aspyra/Rc_Engine_Sound_ESP32/hardware/SMD_ESC-inside_KiCad/RC_Engine_Sound_ESP32.kicad_pcb

## KiCad design hardware/SMD_ESC-inside_KiCad/RC_Engine_Sound_ESP32.kicad_pcb (2023-11-29)

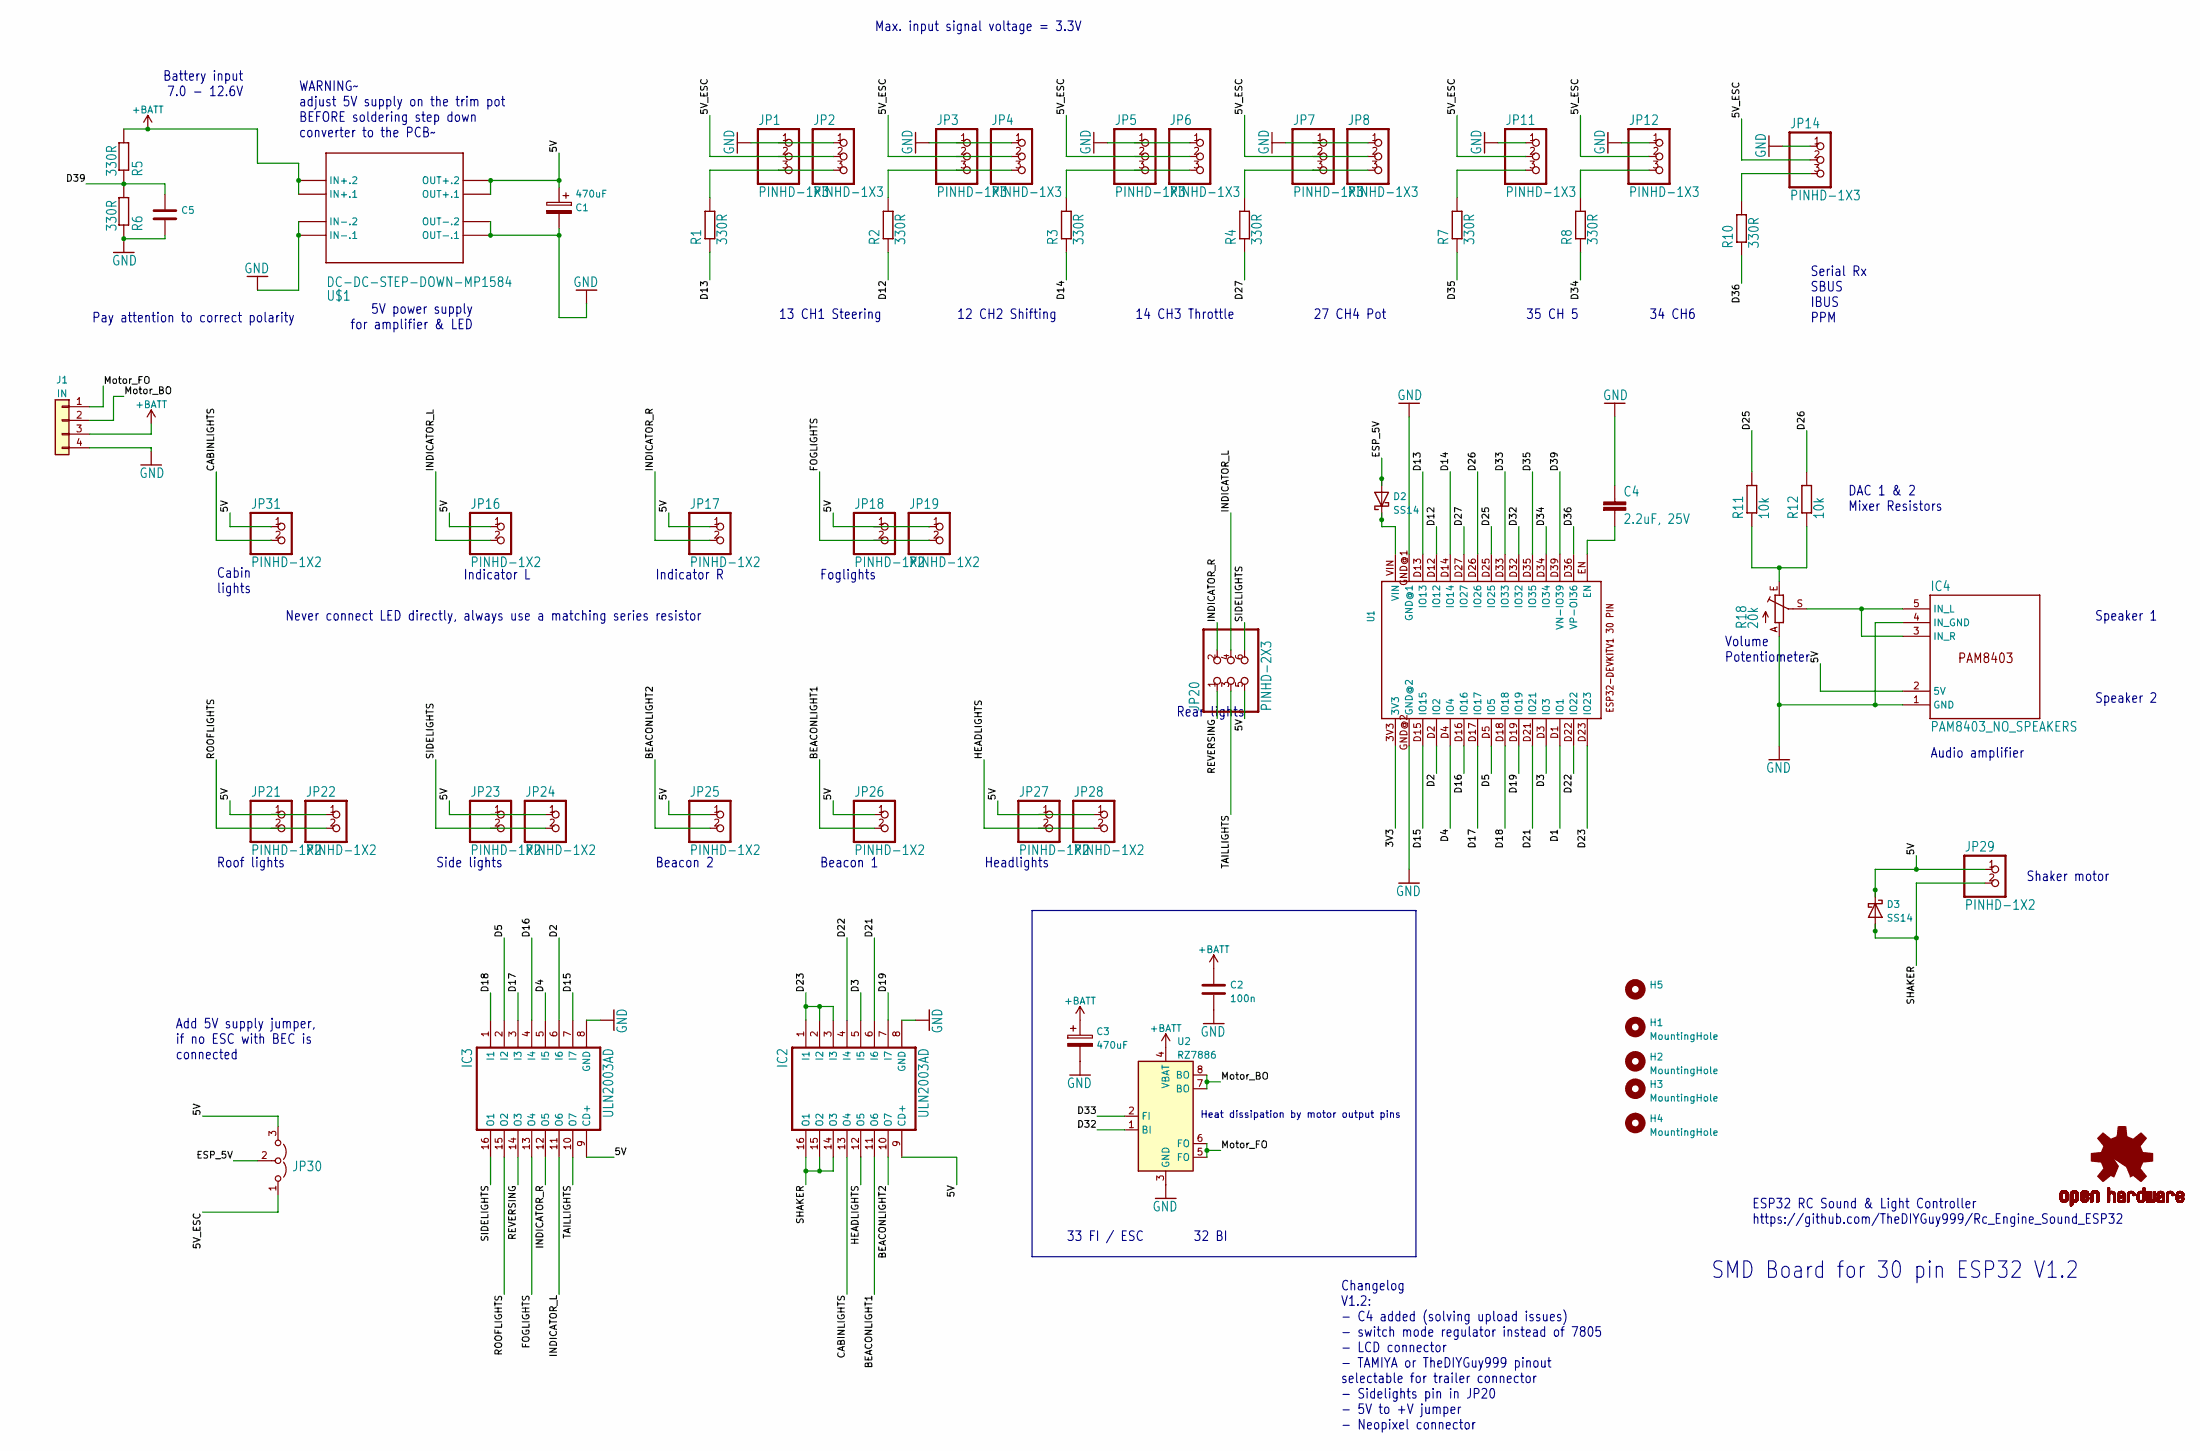
[picture p1: schematic RC_Engine_Sound_ESP32.kicad_sch]

Parts:
C1, C3: 470uF; CP_Radial_D10.0mm_P2.50mm_P5.00mm
C2: 100n; C_0603_1608Metric_Pad1.08x0.95mm_HandSolder
C4: 2.2uF, 25V; C_0805_2012Metric_Pad1.18x1.45mm_HandSolder
C5: C_0603_1608Metric_Pad1.08x0.95mm_HandSolder
D2, D3: SS14; D_SOD-123F
H1, H2, H3, H4: MountingHole; MountingHole_3.2mm_M3_DIN965
H5: (no value)
IC2, IC3: ULN2003AD; SO16
IC4: PAM8403_NO_SPEAKERS; PAM8403_SPEAKERS
J1: IN; TerminalBlock_Phoenix_PT-1,5-4-3.5-H_1x04_P3.50mm_Horizontal
JP1, JP2, JP3, JP4, JP5, JP6, JP7, JP8, JP11, JP12, JP14: PINHD-1X3; 1X03
JP16, JP17, JP18, JP19, JP21, JP22, JP23, JP24, JP25, JP26, JP27, JP28, JP29, JP31: PINHD-1X2; 1X02
JP20: PINHD-2X3; 2X03
JP30: (no value)
LOGO1: OSHW-LOGOM; OSHW-LOGO-M
R1, R2, R3, R4, R5, R6, R7, R8, R10: 330R; R_0603_1608Metric_Pad0.98x0.95mm_HandSolder
R11, R12: 10k; R_0603_1608Metric_Pad0.98x0.95mm_HandSolder
R18: 20k; S64W
U1: ESP32DEVKITV1; ESP32-DEVKITV1
U2: RZ7886; DIP-8_W7.62mm_LongPads
U$1: DC-DC-STEP-DOWN-MP1584

Connections:
+BATT: C2.1, C3.1, J1.3, R5.2, U2.4 (VBAT), U$1.IN+.1, U$1.IN+.2
/3V3: U1.3V3
/5V: C1.1, D3.1 (K), IC2.9 (CD+), IC3.9 (CD+), IC4.2 (5V), JP16.1, JP17.1, JP18.1, JP19.1, JP20.5, JP21.1, JP22.1, JP23.1, JP24.1, JP25.1, JP26.1, JP27.1, JP28.1, JP29.1, JP30.3 (B), JP31.1, U$1.OUT+.1, U$1.OUT+.2
/5V_ESC: JP1.2, JP2.2, JP3.2, JP4.2, JP5.2, JP6.2, JP7.2, JP8.2, JP11.2, JP12.2, JP14.2, JP30.1 (A)
/BEACONLIGHT1: IC2.11 (O6), JP26.2
/BEACONLIGHT2: IC2.10 (O7), JP25.2
/CABINLIGHTS: IC2.13 (O4), JP31.2
/D1: U1.D1 (IO1)
/D2: IC3.6 (I6), U1.D2 (IO2)
/D3: IC2.5 (I5), U1.D3 (IO3)
/D4: IC3.5 (I5), U1.D4 (IO4)
/D5: IC3.2 (I2), U1.D5 (IO5)
/D12: R2.1, U1.D12 (IO12)
/D13: R1.1, U1.D13 (IO13)
/D14: R3.1, U1.D14 (IO14)
/D15: IC3.7 (I7), U1.D15 (IO15)
/D16: IC3.4 (I4), U1.D16 (IO16)
/D17: IC3.3 (I3), U1.D17 (IO17)
/D18: IC3.1 (I1), U1.D18 (IO18)
/D19: IC2.7 (I7), U1.D19 (IO19)
/D21: IC2.6 (I6), U1.D21 (IO21)
/D22: IC2.4 (I4), U1.D22 (IO22)
/D23: IC2.1 (I1), IC2.2 (I2), IC2.3 (I3), U1.D23 (IO23)
/D25: R11.2, U1.D25 (IO25)
/D26: R12.2, U1.D26 (IO26)
/D27: R4.1, U1.D27 (IO27)
/D32: U1.D32 (IO32), U2.1 (BI)
/D33: U1.D33 (IO33), U2.2 (FI)
/D34: R8.1, U1.D34 (IO34)
/D35: R7.1, U1.D35 (IO35)
/D36: R10.1, U1.D36 (VP-OI36)
/D39: C5.1, R5.1, R6.2, U1.D39 (VN-IO39)
/ESP_5V: D2.2 (A), JP30.2 (C)
/FOGLIGHTS: IC3.13 (O4), JP18.2, JP19.2
/HEADLIGHTS: IC2.12 (O5), JP27.2, JP28.2
/INDICATOR_L: IC3.11 (O6), JP16.2, JP20.4
/INDICATOR_R: IC3.12 (O5), JP17.2, JP20.2
/Motor_BO: J1.2, U2.7 (BO), U2.8 (BO)
/Motor_FO: J1.1, U2.5 (FO), U2.6 (FO)
/REVERSING: IC3.14 (O3), JP20.1
/ROOFLIGHTS: IC3.15 (O2), JP21.2, JP22.2
/SHAKER: D3.2 (A), IC2.14 (O3), IC2.15 (O2), IC2.16 (O1), JP29.2
/SIDELIGHTS: IC3.16 (O1), JP20.6, JP23.2, JP24.2
/TAILLIGHTS: IC3.10 (O7), JP20.3
GND: C1.2, C2.2, C3.2, C4.1, C5.2, IC2.8 (GND), IC3.8 (GND), IC4.1 (GND), IC4.4 (IN_GND), J1.4, JP1.1, JP2.1, JP3.1, JP4.1, JP5.1, JP6.1, JP7.1, JP8.1, JP11.1, JP12.1, JP14.1, R6.1, R18.A, U1.GND@1, U1.GND@2, U2.3 (GND), U$1.IN-.1, U$1.IN-.2, U$1.OUT-.1, U$1.OUT-.2
unnamed: C4.2, U1.EN
unnamed: D2.1 (K), U1.VIN
unnamed: IC4.3 (IN_R), IC4.5 (IN_L), R18.S
unnamed: JP1.3, JP2.3, R1.2
unnamed: JP3.3, JP4.3, R2.2
unnamed: JP5.3, JP6.3, R3.2
unnamed: JP7.3, JP8.3, R4.2
unnamed: JP11.3, R7.2
unnamed: JP12.3, R8.2
unnamed: JP14.3, R10.2
unnamed: R11.1, R12.1, R18.E

Notes on the sheet:
Add 5V supply jumper, if no ESC with BEC is connected~{}
Indicator R
Volume Potentiometer
Shaker motor
35 CH 5
Rear lights
Cabin lights
Side lights
Heat dissipation by motor output pins
Max. input signal voltage = 3.3V~{}
Audio amplifier
Pay attention to correct polarity~{}
Foglights
32 BI
13 CH1 Steering
Speaker 2
Beacon 1
Serial Rx SBUS IBUS PPM
Never connect LED directly, always use a matching series resistor~{}
SMD Board for 30 pin ESP32 V1.2
DAC 1 & 2 Mixer Resistors
14 CH3 Throttle
Headlights
5V power supply for amplifier & LED
ESP32 RC Sound & Light Controller https://github.com/TheDIYGuy999/Rc_Engine_Sound_ESP32
Battery input 7.0 - 12.6V
27 CH4 Pot
34 CH6
Beacon 2
Roof lights
33 FI / ESC
WARNING~ adjust 5V supply on the trim pot BEFORE soldering step down converter to the PCB~
12 CH2 Shifting
Changelog V1.2: - C4 added (solving upload issues) - switch mode regulator instead of 7805 - LCD connector - TAMIYA or TheDIYGuy999 pinout selectable for trailer connector - Sidelights pin in JP20 - 5V to +V jumper - Neopixel connector
Indicator L
Speaker 1

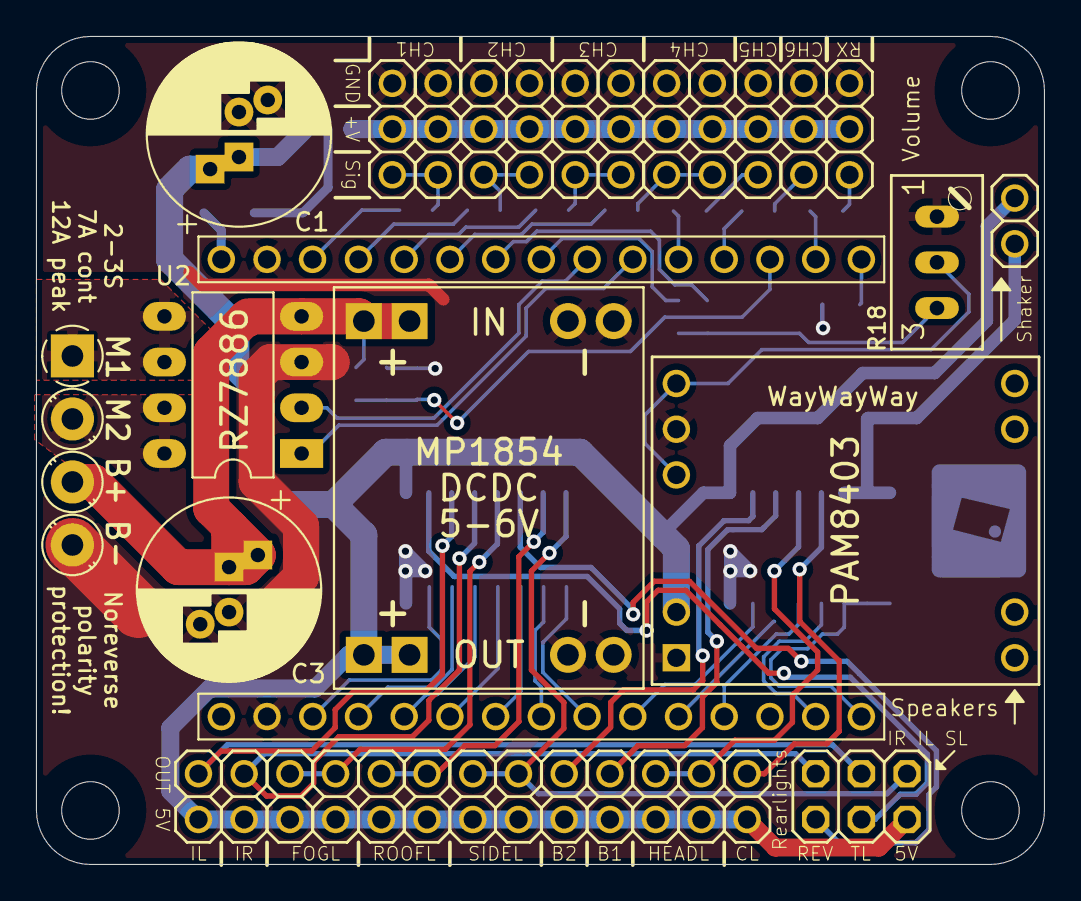
[picture p2: board RC_Engine_Sound_ESP32.kicad_pcb from above]

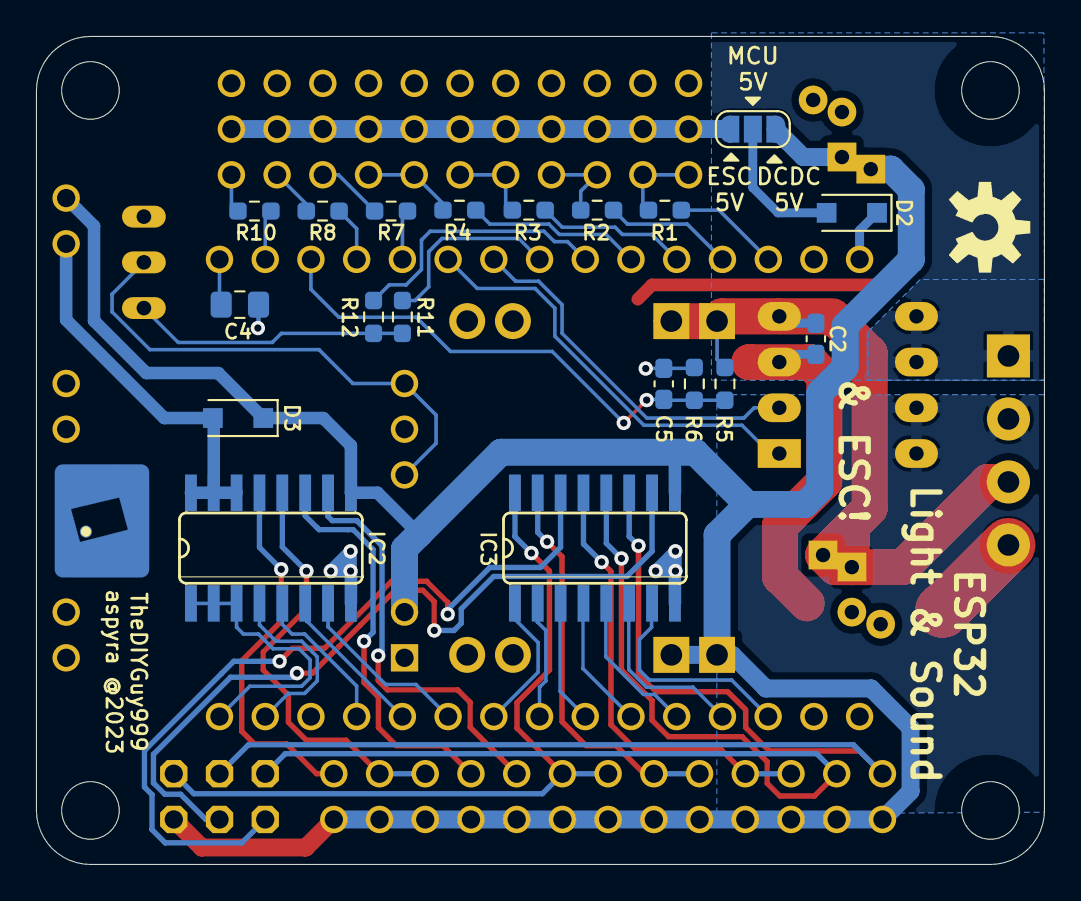
[picture p3: board RC_Engine_Sound_ESP32.kicad_pcb from below]

Board: 2 copper layers, 56.0 x 46.0 mm, 59 parts (21 on the bottom side), 54 nets.
