aspyra/Rc_Engine_Sound_ESP32/src/src.ino

/* RC engine sound & light controller for Arduino ESP32. Written by TheDIYGuy999
    Based on the code for ATmega 328: https://github.com/TheDIYGuy999/Rc_Engine_Sound

    ***** ESP32 CPU frequency must be set to 240MHz! *****

   Sound files converted with: https://github.com/TheDIYGuy999/Rc_Engine_Sound_ESP32/blob/master/tools/Audio2Header.html
   Original converter code by bitluni (send him a high five, if you like the code)

   Parts of automatic transmision code from Wombii's fork: https://github.com/Wombii/Rc_Engine_Sound_ESP32

   Dashboard, Neopixel and SUMD support by Gamadril: https://github.com/Gamadril/Rc_Engine_Sound_ESP32

   Contributors:
   - Christian Fiebig https://github.com/fiechr

   Visual Studio Code IDE support added (you need to install PlatformIO plugin and git https://git-scm.com)
   Arduino IDE is supported as well, but I recommend to use VS Code, because libraries and boards are managed automatically.
*/

char codeVersion[] = "9.12.0"; // Software revision.

//
// =======================================================================================================
// ERROR CODES (INDICATOR LIGHTS, BEEPS)
// =======================================================================================================
//
/*
   Indicators:
   - Constantly on = no SBUS signal (check "sbusInverted" true / false in "2_Remote.h")
   - Number of blinks = this channel signal is not between 1400 and 1600 microseconds and can't be auto calibrated (check channel trim settings)
   - 2 fast blinks = battery error during powering up (see below)
   - 3 fast blinks = no valid receiver bus signal detected / wrong remote configuration

   Beeps (only, if "#define BATTERY_PROTECTION" in "3_ESC.h"):
   - Number of beeps = number of detected battery cells in series
   - 10 fast beeps = battery error, disconnect it!
*/

//
// =======================================================================================================
// ! ! I M P O R T A N T ! !   ALL USER SETTINGS ARE DONE IN THE FOLLOWING TABS, WHICH ARE DISPLAYED ABOVE
// (ADJUST THEM BEFORE CODE UPLOAD), DO NOT CHANGE ANYTHING IN THIS TAB EXCEPT THE DEBUG OPTIONS
// =======================================================================================================
//

#include <Arduino.h>

// All the required user settings are done in the following .h files:
#include "0_generalSettings.h" // <<------- general settings
#include "1_Vehicle.h"         // <<------- Select the vehicle you want to simulate
#include "2_Remote.h"          // <<------- Remote control system related adjustments
#include "3_ESC.h"             // <<------- ESC related adjustments
#include "4_Transmission.h"    // <<------- Transmission related adjustments
#include "5_Shaker.h"          // <<------- Shaker related adjustments
#include "6_Lights.h"          // <<------- Lights related adjustments
#include "7_Servos.h"          // <<------- Servo output related adjustments
#include "8_Sound.h"           // <<------- Sound related adjustments
#include "9_Dashboard.h"       // <<------- Dashboard related adjustments
#include "10_Trailer.h"        // <<------- Trailer related adjustments

// TODO = Things to clean up!

//
// =======================================================================================================
// LIRBARIES & HEADER FILES, REQUIRED ESP32 BOARD DEFINITION
// =======================================================================================================
//
#ifdef bp32
  #include <Bluepad32.h>
#endif
// Libraries (you have to install all of them in the "Arduino sketchbook"/libraries folder)
// !! Do NOT install the libraries in the sketch folder.
// No manual library download is required in Visual Studio Code IDE (see platformio.ini)
#include <statusLED.h>        // https://github.com/TheDIYGuy999/statusLED <<------- required for LED control
#if not defined EMBEDDED_SBUS // SBUS library only required, if not embedded SBUS code is used -----------
#include <SBUS.h>             // https://github.com/TheDIYGuy999/SBUS      <<------- you need to install my fork of this library!
#endif                        // ------------------------------------------------------------------------------------------------
#include <rcTrigger.h>        // https://github.com/TheDIYGuy999/rcTrigger <<------- required for RC signal processing
#include <IBusBM.h>           // https://github.com/bmellink/IBusBM        <<------- required for IBUS interface
#include <TFT_eSPI.h>         // https://github.com/Bodmer/TFT_eSPI        <<------- required for LCD dashboard. Use v2.3.70
#if defined NEOPIXEL_ENABLED
#include <FastLED.h> // https://github.com/FastLED/FastLED        <<------- required for Neopixel support. Use V3.3.3
#endif
//#include <ESP32AnalogRead.h> // https://github.com/madhephaestus/ESP32AnalogRead <<------- required for battery voltage measurement
#include <Tone32.h>          // https://github.com/lbernstone/Tone32      <<------- required for battery cell detection beeps // Not for platform = espressif32@4.3.0

// Additional headers (included)
#include "src/curves.h"    // Nonlinear throttle curve arrays
#include "src/helper.h"    // Various stuff
#include "src/dashboard.h" // For LCD dashboard. See: https://github.com/Gamadril/Rc_Engine_Sound_ESP32
#include "src/SUMD.h"      // For Graupner SUMD interface. See: https://github.com/Gamadril/Rc_Engine_Sound_ESP32
#if defined EMBEDDED_SBUS
#include "src/sbus.h" // For SBUS interface
#endif

// No need to install these, they come with the ESP32 board definition
#include "driver/uart.h"  // for UART macro UART_PIN_NO_CHANGE
#include "driver/rmt.h"   // for PWM signal detection
#include "driver/mcpwm.h" // for servo PWM output
#include "rom/rtc.h"      // for displaying reset reason
#include "soc/rtc_wdt.h"  // for watchdog timer
#include <Esp.h>    // for displaying memory information
#include <EEPROM.h> // for non volatile variable storage

// This stuff is required for Visual Studio Code IDE, if .ino is renamed into .cpp!
void Task1code(void *parameters);
void readSbusCommands();
void readIbusCommands();
void readSumdCommands();
void readPpmCommands();
void readPwmSignals();
void processRawChannels();
void failsafeRcSignals();
void channelZero();
float batteryVolts();
void eepromDebugRead();
void eepromRead();
void eepromInit();

// The following tasks only required for Arduino IDE! ----
// Install ESP32 board according to: https://randomnerdtutorials.com/installing-the-esp32-board-in-arduino-ide-windows-instructions/
// Warning: Use Espressif ESP32 board definition v1.05 or 10.6! v2.x is not working
// Adjust board settings according to: https://github.com/TheDIYGuy999/Rc_Engine_Sound_ESP32/blob/master/pictures/settings.png

// Visual Studio Code IDE instructions: ----
// - General settings are done in platformio.ini
// - !!IMPORTANT!! Rename src.ini to scr.cpp -> This will prevent potential compiler errors

// Make sure to remove -master from your sketch folder name

//
// =======================================================================================================
// PIN ASSIGNMENTS & GLOBAL VARIABLES (Do not play around here)
// =======================================================================================================
//
// Pin assignment and wiring instructions ****************************************************************

// ------------------------------------------------------------------------------------
// Use a 330Ohm resistor in series with all I/O pins! allows to drive LED directly and
// provides short circuit protection. Also works on the serial Rx pin "VP" (36)
// ------------------------------------------------------------------------------------

// Serial DEBUG pins -----
#define DEBUG_RX UART_PIN_NO_CHANGE // 99 is just a dummy, because the "RX0" pin (GPIO3) is used for the headlights and causing issues, if rx enabled! -1 (3 headlights)
#define DEBUG_TX 1                  // The "RX0" is on pin 1

// Serial command pins for SBUS, IBUS, PPM, SUMD -----
#define COMMAND_RX 36                 // pin 36, labelled with "VP", connect it to "Micro RC Receiver" pin "TXO"
#define COMMAND_TX UART_PIN_NO_CHANGE // 98 is just a dummy -1 (17 reversing)

#define BATTERY_DETECT_PIN 39 // Voltage divider resistors connected to pin "VN & GND"

// PWM RC signal input pins (active, if no other communications profile is enabled) -----
// Channel numbers may be different on your recveiver!
// CH1: (steering)
// CH2: (gearbox) (left throttle in TRACKED_MODE)
// CH3: (throttle) (right throttle in TRACKED_MODE)
// CH4: (horn and bluelight / siren)
// CH5: (high / low beam, transmission neutral, jake brake etc.)
// CH6: (indicators, hazards)
#define PWM_CHANNELS_NUM 6                                           // Number of PWM signal input pins 6
const uint8_t PWM_CHANNELS[PWM_CHANNELS_NUM] = {1, 2, 3, 4, 5, 6};   // Channel numbers
const uint8_t PWM_PINS[PWM_CHANNELS_NUM] = {13, 12, 14, 27, 35, 34}; // Input pin numbers (pin 34 & 35 only usable as inputs!)

// Output pins -----
#define ESC_OUT_PIN 33 // connect crawler type ESC here. Not supported in TRACKED_MODE -----

#define RZ7886_PIN1 33 // RZ7886 motor driver pin 1 (same as ESC_OUT_PIN)
#define RZ7886_PIN2 32 // RZ7886 motor driver pin 2 (same as BRAKELIGHT_PIN)

#define STEERING_PIN 13 // CH1 output for steering servo (bus communication only)
#define SHIFTING_PIN 12 // CH2 output for shifting servo (bus communication only)
#define WINCH_PIN 14    // CH3 output for winch servo (bus communication only)
#define COUPLER_PIN 27  // CH4 output for coupler (5th. wheel) servo (bus communication only)

#ifdef WEMOS_D1_MINI_ESP32 // switching headlight pin depending on the board variant
#define HEADLIGHT_PIN 22   // Headlights connected to GPIO 22
#define CABLIGHT_PIN -1    // No Cabin lights
#define NO_CABLIGHTS
#else
#define HEADLIGHT_PIN 3 // Headlights connected to GPIO 3
#define CABLIGHT_PIN 22 // Cabin lights connected to GPIO 22
#endif

#define TAILLIGHT_PIN 15       // Red tail- & brake-lights (combined)
#define INDICATOR_LEFT_PIN 2   // Orange left indicator (turn signal) light
#define INDICATOR_RIGHT_PIN 4  // Orange right indicator (turn signal) light
#define FOGLIGHT_PIN 16        // (16 = RX2) Fog lights
#define REVERSING_LIGHT_PIN 17 // (TX2) White reversing light
#define ROOFLIGHT_PIN 5        // Roof lights (high beam, if "define SEPARATE_FULL_BEAM")
#define SIDELIGHT_PIN 18       // Side lights (connect roof ligthts here, if "define SEPARATE_FULL_BEAM")
#define BEACON_LIGHT2_PIN 19   // Blue beacons light
#define BEACON_LIGHT1_PIN 21   // Blue beacons light

#define RGB_LEDS_PIN 0 // Pin is used for WS2812 LED control

#if defined THIRD_BRAKELIGHT
#define BRAKELIGHT_PIN 32 // Upper brake lights
#else
#define COUPLER_SWITCH_PIN 32 // switch for trailer coupler sound
#endif

#define SHAKER_MOTOR_PIN 23 // Shaker motor (shaking truck while idling and engine start / stop)

#define DAC1 25 // connect pin25 (do not change the pin) to a 10kOhm resistor
#define DAC2 26 // connect pin26 (do not change the pin) to a 10kOhm resistor
// both outputs of the resistors above are connected together and then to the outer leg of a
// 20kOhm potentiometer. The other outer leg connects to GND. The middle leg connects to both inputs
// of a PAM8403 amplifier and allows to adjust the volume. This way, two speakers can be used.

// Objects *************************************************************************************
// Status LED objects (also used for PWM shaker motor and ESC control) -----
statusLED headLight(false); // "false" = output not inversed
statusLED tailLight(false);
statusLED indicatorL(false);
statusLED indicatorR(false);
statusLED fogLight(false);
statusLED reversingLight(false);
statusLED roofLight(false);
statusLED sideLight(false);
statusLED beaconLight1(false);
statusLED beaconLight2(false);
statusLED shakerMotor(false);
statusLED cabLight(false);
statusLED brakeLight(false);

// rcTrigger objects -----
// Analog or 3 position switches (short / long pressed time)
rcTrigger functionR100u(200); // 200ms required!
rcTrigger functionR100d(100);
rcTrigger functionR75u(300); // 300ms required!
rcTrigger functionR75d(300); // 300ms required!
rcTrigger functionL100l(100);
rcTrigger functionL100r(100);
rcTrigger functionL75l(300); // 300ms required!
rcTrigger functionL75r(300); // 300ms required!

// Latching 2 position
rcTrigger mode1Trigger(100);
rcTrigger mode2Trigger(100);

// momentary buttons
rcTrigger momentary1Trigger(100);

// Flags
rcTrigger hazardsTrigger(100);
rcTrigger indicatorLTrigger(100);
rcTrigger indicatorRTrigger(100);

// Other objects -----
// Dashboard
Dashboard dashboard;

#if defined NEOPIXEL_ENABLED
// Neopixel
CRGB rgbLEDs[NEOPIXEL_COUNT];
#endif

// Battery voltage
//ESP32AnalogRead battery;

// Global variables **********************************************************************

// WiFi variables
String ssid;
String password;

// MAC address for communication with tractor TODO
uint8_t customMACAddress[] = {0x00, 0x00, 0x00, 0x00, 0x00, 0x00};

// HTTP request memory
String header;

// For HTTP GET value
String valueString = "";
int pos1 = 0;
int pos2 = 0;

// PWM processing variables
#define RMT_TICK_PER_US 1
// determines how many clock cycles one "tick" is
// [1..255], source is generally 80MHz APB clk
#define RMT_RX_CLK_DIV (80000000 / RMT_TICK_PER_US / 1000000)
// time before receiver goes idle (longer pulses will be ignored)
#define RMT_RX_MAX_US 3500
volatile uint16_t pwmBuf[PWM_CHANNELS_NUM + 2] = {0};
uint32_t maxPwmRpmPercentage = 390; // Limit required to prevent controller from crashing @ high engine RPM

// PPM signal processing variables
#define NUM_OF_PPM_CHL 8                       // The number of channels inside our PPM signal (8 is the maximum!)
#define NUM_OF_PPM_AVG 1                       // Number of averaging passes (usually one, more will be slow)
volatile int ppmInp[NUM_OF_PPM_CHL + 1] = {0}; // Input values
volatile int ppmBuf[16] = {0};
volatile byte counter = NUM_OF_PPM_CHL;
volatile byte average = NUM_OF_PPM_AVG;
volatile boolean ready = false;
volatile unsigned long timelast;
unsigned long timelastloop;
uint32_t maxPpmRpmPercentage = 390; // Limit required to prevent controller from crashing @ high engine RPM

// SBUS signal processing variables
#if not defined EMBEDDED_SBUS // ------------------------
SBUS sBus(Serial2);           // SBUS object on Serial 2 port
// channel, fail safe, and lost frames data
uint16_t SBUSchannels[16];
bool SBUSfailSafe;
bool SBUSlostFrame;
#else  // ------------------------------------------------
bfs::SbusRx sBus(&Serial2);
std::array<int16_t, bfs::SbusRx::NUM_CH()> SBUSchannels;
#endif // -----------------------------------------------
bool sbusInit;
uint32_t maxSbusRpmPercentage = 390; // Limit required to prevent controller from crashing @ high engine RPM

// SUMD signal processing variables
HardwareSerial serial(2);
SUMD sumd(serial); // SUMD object on Serial 2 port
// channel, fail safe, and lost frames data
uint16_t SUMDchannels[16]; // only 12 are usable!
bool SUMD_failsafe;
bool SUMD_frame_lost;
bool SUMD_init;
uint32_t maxSumdRpmPercentage = 390; // Limit required to prevent controller from crashing @ high engine RPM

// IBUS signal processing variables
IBusBM iBus; // IBUS object
bool ibusInit;
uint32_t maxIbusRpmPercentage = 320; // Limit required to prevent controller from crashing @ high engine RPM (was 350, but sometimes crashing)

// Interrupt latches
volatile boolean couplerSwitchInteruptLatch; // this is enabled, if the coupler switch pin change interrupt is detected

// Control input signals
#define PULSE_ARRAY_SIZE 14                // 13 channels (+ the unused CH0)
uint16_t pulseWidthRaw[PULSE_ARRAY_SIZE];  // Current RC signal RAW pulse width [X] = channel number
uint16_t pulseWidthRaw2[PULSE_ARRAY_SIZE]; // Current RC signal RAW pulse width with linearity compensation [X] = channel number
uint16_t pulseWidthRaw3[PULSE_ARRAY_SIZE]; // Current RC signal RAW pulse width before averaging [X] = channel number
uint16_t pulseWidth[PULSE_ARRAY_SIZE];     // Current RC signal pulse width [X] = channel number
int16_t pulseOffset[PULSE_ARRAY_SIZE];     // Offset for auto zero adjustment

uint16_t pulseMaxNeutral[PULSE_ARRAY_SIZE]; // PWM input signal configuration storage variables
uint16_t pulseMinNeutral[PULSE_ARRAY_SIZE];
uint16_t pulseMax[PULSE_ARRAY_SIZE];
uint16_t pulseMin[PULSE_ARRAY_SIZE];
uint16_t pulseMaxLimit[PULSE_ARRAY_SIZE];
uint16_t pulseMinLimit[PULSE_ARRAY_SIZE];

uint16_t pulseZero[PULSE_ARRAY_SIZE]; // Usually 1500 (The mid point of 1000 - 2000 Microseconds)
uint16_t pulseLimit = 1100;           // pulseZero +/- this value (1100)
uint16_t pulseMinValid = 700;         // The minimum valid pulsewidth (was 950)
uint16_t pulseMaxValid = 2300;        // The maximum valid pulsewidth (was 2050)
bool autoZeroDone;                    // Auto zero offset calibration done
#define NONE 16                       // The non existing "Dummy" channel number (usually 16) TODO

volatile boolean failSafe = false; // Triggered in emergency situations like: throttle signal lost etc.

boolean mode1; // Signal state variables
boolean mode2;
boolean momentary1;
boolean hazard;
boolean left;
boolean right;
boolean unlock5thWheel;
boolean winchPull;
boolean winchRelease;

boolean winchEnabled;

// Sound
volatile boolean engineOn = false;                // Signal for engine on / off
volatile boolean engineStart = false;             // Active, if engine is starting up
volatile boolean engineRunning = false;           // Active, if engine is running
volatile boolean engineStop = false;              // Active, if engine is shutting down
volatile boolean jakeBrakeRequest = false;        // Active, if engine jake braking is requested
volatile boolean engineJakeBraking = false;       // Active, if engine is jake braking
volatile boolean wastegateTrigger = false;        // Trigger wastegate (blowoff) after rapid throttle drop
volatile boolean blowoffTrigger = false;          // Trigger jake brake sound (blowoff) after rapid throttle drop
volatile boolean dieselKnockTrigger = false;      // Trigger Diesel ignition "knock"
volatile boolean dieselKnockTriggerFirst = false; // The first Diesel ignition "knock" per sequence
volatile boolean airBrakeTrigger = false;         // Trigger for air brake noise
volatile boolean parkingBrakeTrigger = false;     // Trigger for air parking brake noise
volatile boolean shiftingTrigger = false;         // Trigger for shifting noise
volatile boolean hornTrigger = false;             // Trigger for horn on / off
volatile boolean sirenTrigger = false;            // Trigger for siren  on / off
volatile boolean sound1trigger = false;           // Trigger for sound1  on / off
volatile boolean couplingTrigger = false;         // Trigger for trailer coupling  sound
volatile boolean uncouplingTrigger = false;       // Trigger for trailer uncoupling  sound
volatile boolean bucketRattleTrigger = false;     // Trigger for bucket rattling  sound
volatile boolean indicatorSoundOn = false;        // active, if indicator bulb is on
volatile boolean outOfFuelMessageTrigger = false; // Trigger for out of fuel message

// Sound latches
volatile boolean hornLatch = false;  // Horn latch bit
volatile boolean sirenLatch = false; // Siren latch bit

// Sound volumes
volatile uint16_t throttleDependentVolume = 0;        // engine volume according to throttle position
volatile uint16_t throttleDependentRevVolume = 0;     // engine rev volume according to throttle position
volatile uint16_t rpmDependentJakeBrakeVolume = 0;    // Engine rpm dependent jake brake volume
volatile uint16_t throttleDependentKnockVolume = 0;   // engine Diesel knock volume according to throttle position
volatile uint16_t rpmDependentKnockVolume = 0;        // engine Diesel knock volume according to engine RPM
volatile uint16_t throttleDependentTurboVolume = 0;   // turbo volume according to rpm
volatile uint16_t throttleDependentFanVolume = 0;     // cooling fan volume according to rpm
volatile uint16_t throttleDependentChargerVolume = 0; // cooling fan volume according to rpm
volatile uint16_t rpmDependentWastegateVolume = 0;    // wastegate volume according to rpm
volatile uint16_t tireSquealVolume = 0;               // Tire squeal volume according to speed and cornering radius
// for excavator mode:
volatile uint16_t hydraulicPumpVolume = 0;             // hydraulic pump volume
volatile uint16_t hydraulicFlowVolume = 0;             // hydraulic flow volume
volatile uint16_t trackRattleVolume = 0;               // track rattling volume
volatile uint16_t hydraulicDependentKnockVolume = 100; // engine Diesel knock volume according to hydraulic load
volatile uint16_t hydraulicLoad = 0;                   // Hydraulic load dependent RPM drop

volatile uint64_t dacDebug = 0; // DAC debug variable TODO

volatile int16_t masterVolume = 100; // Master volume percentage
volatile uint8_t dacOffset = 0;      // 128, but needs to be ramped up slowly to prevent popping noise, if switched on

// Throttle
int16_t currentThrottle = 0;      // 0 - 500 (Throttle trigger input)
int16_t currentThrottleFaded = 0; // faded throttle for volume calculations etc.

// Engine
const int16_t maxRpm = 500;       // always 500
const int16_t minRpm = 0;         // always 0
int32_t currentRpm = 0;           // 0 - 500 (signed required!)
volatile uint8_t engineState = 0; // Engine state
enum EngineState                  // Engine state enum
{
  OFF,      // Engine is off
  STARTING, // Engine is starting
  RUNNING,  // Engine is running
  STOPPING, // Engine is stopping
  PARKING_BRAKE
};
int16_t engineLoad = 0;                 // 0 - 500
volatile uint16_t engineSampleRate = 0; // Engine sample rate
int32_t speedLimit = maxRpm;            // The speed limit, depending on selected virtual gear

// Clutch
boolean clutchDisengaged = true; // Active while clutch is disengaged

// Transmission
uint8_t selectedGear = 1;             // The currently used gear of our shifting gearbox
uint8_t selectedAutomaticGear = 1;    // The currently used gear of our automatic gearbox
boolean gearUpShiftingInProgress;     // Active while shifting upwards
boolean doubleClutchInProgress;       // Double-clutch (Zwischengas)
boolean gearDownShiftingInProgress;   // Active while shifting downwards
boolean gearUpShiftingPulse;          // Active, if shifting upwards begins
boolean gearDownShiftingPulse;        // Active, if shifting downwards begins
volatile boolean neutralGear = false; // Transmission in neutral
boolean lowRange = false;             // Transmission range (off road reducer)

// ESC
volatile boolean escIsBraking = false; // ESC is in a braking state
volatile boolean escIsDriving = false; // ESC is in a driving state
volatile boolean escInReverse = false; // ESC is driving or braking backwards
volatile boolean brakeDetect = false;  // Additional brake detect signal, enabled immediately, if brake applied
int8_t driveState = 0;                 // for ESC state machine
uint16_t escPulseMax = 2000;           // ESC calibration variables (values will be changed later)
uint16_t escPulseMin = 1000;
uint16_t escPulseMaxNeutral = 1500;
uint16_t escPulseMinNeutral = 1500;
uint16_t currentSpeed = 0;         // 0 - 500 (current ESC power)
volatile bool crawlerMode = false; // Crawler mode intended for crawling competitons (withouth sound and virtual inertia)

// Lights
int8_t lightsState = 0;                        // for lights state machine
volatile boolean lightsOn = false;             // Lights on
volatile boolean headLightsFlasherOn = false;  // Headlights flasher impulse (Lichthupe)
volatile boolean headLightsHighBeamOn = false; // Headlights high beam (Fernlicht)
volatile boolean blueLightTrigger = false;     // Bluelight on (Blaulicht)
boolean indicatorLon = false;                  // Left indicator (Blinker links)
boolean indicatorRon = false;                  // Right indicator (Blinker rechts)
boolean fogLightOn = false;                    // Fog light is on
boolean cannonFlash = false;                   // Flashing cannon fire

// Trailer
bool legsUp;
bool legsDown;
bool rampsUp;
bool rampsDown;
bool trailerDetected;

// Battery
float batteryCutoffvoltage;
float batteryVoltage;
uint8_t numberOfCells;
bool batteryProtection = false;

// ESP NOW variables for wireless trailer communication ----------------------------
#if defined ENABLE_WIRELESS

volatile uint16_t pollRate = 20;

esp_now_peer_info_t peerInfo; // This MUST be global!! Transmission is not working otherwise!

typedef struct struct_message
{ // This is the data packet
  uint8_t tailLight;
  uint8_t sideLight;
  uint8_t reversingLight;
  uint8_t indicatorL;
  uint8_t indicatorR;
  bool legsUp;
  bool legsDown;
  bool rampsUp;
  bool rampsDown;
  bool beaconsOn;
} struct_message;

// Create a struct_message called trailerData
struct_message trailerData;
#endif // --------------------------------------------------------------------------

// The following variables are buffered in the eeprom an can be modified, using the web interface -----
// 5th wheel switch enable / disable
bool fifthWhweelDetectionActive = true;

bool useTrailer1;
bool useTrailer2;
bool useTrailer3;

uint8_t broadcastAddress1[6];
uint8_t broadcastAddress2[6];
uint8_t broadcastAddress3[6];

// Eeprom size and storage addresses ----------------------------------------------
#define EEPROM_SIZE 256 // 256 Bytes (512 is maximum)

#define adr_eprom_init 0 // Eeprom initialized or not?

#define adr_eprom_useTrailer1 4 // Trailer 1
#define adr_eprom_Trailer1Mac0 8
#define adr_eprom_Trailer1Mac1 12
#define adr_eprom_Trailer1Mac2 16
#define adr_eprom_Trailer1Mac3 20
#define adr_eprom_Trailer1Mac4 24
#define adr_eprom_Trailer1Mac5 28

#define adr_eprom_useTrailer2 32 // Trailer 2
#define adr_eprom_Trailer2Mac0 36
#define adr_eprom_Trailer2Mac1 40
#define adr_eprom_Trailer2Mac2 44
#define adr_eprom_Trailer2Mac3 48
#define adr_eprom_Trailer2Mac4 52
#define adr_eprom_Trailer2Mac5 56

#define adr_eprom_useTrailer3 60 // Trailer 3
#define adr_eprom_Trailer3Mac0 64
#define adr_eprom_Trailer3Mac1 68
#define adr_eprom_Trailer3Mac2 72
#define adr_eprom_Trailer3Mac3 76
#define adr_eprom_Trailer3Mac4 80
#define adr_eprom_Trailer3Mac5 84

#define adr_eprom_fifthWhweelDetectionActive 88
#define adr_eprom_tailLightBrightness 92
#define adr_eprom_sideLightBrightness 96
#define adr_eprom_reversingLightBrightness 100
#define adr_eprom_indicatorLightBrightness 104
#define adr_eprom_ssid 192     // 192
#define adr_eprom_password 224 // 224

// DEBUG stuff
volatile uint8_t coreId = 99;

// Our main tasks
TaskHandle_t Task1;

// Loop time (for debug)
uint16_t loopTime;

// Sampling intervals for interrupt timer (adjusted according to your sound file sampling rate)
uint32_t maxSampleInterval = 4000000 / sampleRate;
uint32_t minSampleInterval = 4000000 / sampleRate * 100 / MAX_RPM_PERCENTAGE;

// Interrupt timer for variable sample rate playback (engine sound)
hw_timer_t *variableTimer = NULL;
portMUX_TYPE variableTimerMux = portMUX_INITIALIZER_UNLOCKED;
volatile uint32_t variableTimerTicks = maxSampleInterval;

// Interrupt timer for fixed sample rate playback (horn etc., playing in parallel with engine sound)
hw_timer_t *fixedTimer = NULL;
portMUX_TYPE fixedTimerMux = portMUX_INITIALIZER_UNLOCKED;
volatile uint32_t fixedTimerTicks = maxSampleInterval;

// Declare a mutex Semaphore Handles.
// It will be used to ensure only only one Task is accessing this resource at any time.
SemaphoreHandle_t xPwmSemaphore;
SemaphoreHandle_t xRpmSemaphore;

// These are used to print the reset reason on startup
const char *RESET_REASONS[] = {"POWERON_RESET", "NO_REASON", "SW_RESET", "OWDT_RESET", "DEEPSLEEP_RESET", "SDIO_RESET", "TG0WDT_SYS_RESET", "TG1WDT_SYS_RESET", "RTCWDT_SYS_RESET", "INTRUSION_RESET", "TGWDT_CPU_RESET", "SW_CPU_RESET", "RTCWDT_CPU_RESET", "EXT_CPU_RESET", "RTCWDT_BROWN_OUT_RESET", "RTCWDT_RTC_RESET"};

// Convert µs to degrees (°)
float us2degree(uint16_t value)
{
  return (value - 500) / 11.111 - 90.0;
}

//
// =======================================================================================================
// INTERRUPT FOR VARIABLE SPEED PLAYBACK (Engine sound, turbo sound)
// =======================================================================================================
//

void IRAM_ATTR variablePlaybackTimer()
{

  // coreId = xPortGetCoreID(); // Running on core 1

  static uint32_t attenuatorMillis = 0;
  static uint32_t curEngineSample = 0;          // Index of currently loaded engine sample
  static uint32_t curRevSample = 0;             // Index of currently loaded engine rev sample
  static uint32_t curTurboSample = 0;           // Index of currently loaded turbo sample
  static uint32_t curFanSample = 0;             // Index of currently loaded fan sample
  static uint32_t curChargerSample = 0;         // Index of currently loaded charger sample
  static uint32_t curStartSample = 0;           // Index of currently loaded start sample
  static uint32_t curJakeBrakeSample = 0;       // Index of currently loaded jake brake sample
  static uint32_t curHydraulicPumpSample = 0;   // Index of currently loaded hydraulic pump sample
  static uint32_t curTrackRattleSample = 0;     // Index of currently loaded train track rattle sample
  static uint32_t lastDieselKnockSample = 0;    // Index of last Diesel knock sample
  static uint16_t attenuator = 0;               // Used for volume adjustment during engine switch off
  static uint16_t speedPercentage = 0;          // slows the engine down during shutdown
  static int32_t a, a1, a2, a3, b, c, d, e = 0; // Input signals for mixer: a = engine, b = additional sound, c = turbo sound, d = fan sound, e = supercharger sound
  static int32_t f = 0;                         // Input signals for mixer: f = hydraulic pump
  static int32_t g = 0;                         // Input signals for mixer: g = train track rattle
  uint8_t a1Multi = 0;                          // Volume multipliers

  // portENTER_CRITICAL_ISR(&variableTimerMux); // disables C callable interrupts (on the current core) and locks the mutex by the current core.

  switch (engineState)
  {

  case OFF:                                                   // Engine off -----------------------------------------------------------------------
    variableTimerTicks = 4000000 / startSampleRate;           // our fixed sampling rate
    timerAlarmWrite(variableTimer, variableTimerTicks, true); // // change timer ticks, autoreload true

    a = 0; // volume = zero
    if (engineOn)
    {
      engineState = STARTING;
      engineStart = true;
    }
    break;

  case STARTING:                                              // Engine start --------------------------------------------------------------------
    variableTimerTicks = 4000000 / startSampleRate;           // our fixed sampling rate
    timerAlarmWrite(variableTimer, variableTimerTicks, true); // // change timer ticks, autoreload true

    if (curStartSample < startSampleCount - 1)
    {
#if defined STEAM_LOCOMOTIVE_MODE
      a = (startSamples[curStartSample] * startVolumePercentage / 100);
#else
      a = (startSamples[curStartSample] * throttleDependentVolume / 100 * startVolumePercentage / 100);
#endif
      curStartSample++;
    }
    else
    {
      curStartSample = 0;
      engineState = RUNNING;
      engineStart = false;
      engineRunning = true;
      airBrakeTrigger = true;
    }
    break;

  case RUNNING: // Engine running ------------------------------------------------------------------

    // Engine idle & revving sounds (mixed together according to engine rpm, new in v5.0)
    variableTimerTicks = engineSampleRate;                    // our variable idle sampling rate!
    timerAlarmWrite(variableTimer, variableTimerTicks, true); // // change timer ticks, autoreload true

    if (!engineJakeBraking && !blowoffTrigger)
    {
      if (curEngineSample < sampleCount - 1)
      {
        a1 = (samples[curEngineSample] * throttleDependentVolume / 100 * idleVolumePercentage / 100); // Idle sound
        a3 = 0;
        curEngineSample++;

        // Optional rev sound, recorded at medium rpm. Note, that it needs to represent the same number of ignition cycles as the
        // idle sound. For example 4 or 8 for a V8 engine. It also needs to have about the same length. In order to adjust the length
        // or "revSampleCount", change the "Rate" setting in Audacity until it is about the same.
#ifdef REV_SOUND
        a2 = (revSamples[curRevSample] * throttleDependentRevVolume / 100 * revVolumePercentage / 100); // Rev sound
        if (curRevSample < revSampleCount)
          curRevSample++;
#endif

        // Trigger throttle dependent Diesel ignition "knock" sound (played in the fixed sample rate interrupt)
        if (curEngineSample - lastDieselKnockSample > (sampleCount / dieselKnockInterval))
        {
          dieselKnockTrigger = true;
          dieselKnockTriggerFirst = false;
          lastDieselKnockSample = curEngineSample;
        }
      }
      else
      {
        curEngineSample = 0;
        if (jakeBrakeRequest)
          engineJakeBraking = true;
#ifdef REV_SOUND
        curRevSample = 0;
#endif
        lastDieselKnockSample = 0;
        dieselKnockTrigger = true;
        dieselKnockTriggerFirst = true;
      }
      curJakeBrakeSample = 0;
    }
    else
    { // Jake brake sound ----
#ifdef JAKE_BRAKE_SOUND
      a3 = (jakeBrakeSamples[curJakeBrakeSample] * rpmDependentJakeBrakeVolume / 100 * jakeBrakeVolumePercentage / 100); // Jake brake sound
      a2 = 0;
      a1 = 0;
      if (curJakeBrakeSample < jakeBrakeSampleCount - 1)
        curJakeBrakeSample++;
      else
      {
        curJakeBrakeSample = 0;
        if (!jakeBrakeRequest)
          engineJakeBraking = false;
      }

      curEngineSample = 0;
      curRevSample = 0;
#endif
    }

    // Engine sound mixer ----
#ifdef REV_SOUND
    // Mixing the idle and rev sounds together, according to engine rpm
    // Below the "revSwitchPoint" target, the idle volume precentage is 90%, then falling to 0% @ max. rpm.
    // The total of idle and rev volume percentage is always 100%

    if (currentRpm > revSwitchPoint)
      a1Multi = map(currentRpm, idleEndPoint, revSwitchPoint, 0, idleVolumeProportionPercentage);
    else
      a1Multi = idleVolumeProportionPercentage; // 90 - 100% proportion
    if (currentRpm > idleEndPoint)
      a1Multi = 0;

    a1 = a1 * a1Multi / 100;         // Idle volume
    a2 = a2 * (100 - a1Multi) / 100; // Rev volume

    a = a1 + a2 + a3; // Idle and rev sounds mixed together
#else
    a = a1 + a3; // Idle sound only
#endif

    // Turbo sound ----------------------------------
    if (curTurboSample < turboSampleCount - 1)
    {
      c = (turboSamples[curTurboSample] * throttleDependentTurboVolume / 100 * turboVolumePercentage / 100);
      curTurboSample++;
    }
    else
    {
      curTurboSample = 0;
    }

    // Fan sound -----------------------------------
    if (curFanSample < fanSampleCount - 1)
    {
      d = (fanSamples[curFanSample] * throttleDependentFanVolume / 100 * fanVolumePercentage / 100);
      curFanSample++;
    }
    else
    {
      curFanSample = 0;
    }
#if defined GEARBOX_WHINING
    if (neutralGear)
      d = 0; // used for gearbox whining simulation, so not active in gearbox neutral
#endif

    // Supercharger sound --------------------------
    if (curChargerSample < chargerSampleCount - 1)
    {
      e = (chargerSamples[curChargerSample] * throttleDependentChargerVolume / 100 * chargerVolumePercentage / 100);
      curChargerSample++;
    }
    else
    {
      curChargerSample = 0;
    }

    // Hydraulic pump sound -----------------------
#if defined EXCAVATOR_MODE
    if (curHydraulicPumpSample < hydraulicPumpSampleCount - 1)
    {
      f = (hydraulicPumpSamples[curHydraulicPumpSample] * hydraulicPumpVolumePercentage / 100 * hydraulicPumpVolume / 100);
      curHydraulicPumpSample++;
    }
    else
    {
      curHydraulicPumpSample = 0;
    }
#endif

#if defined STEAM_LOCOMOTIVE_MODE
    // Track rattle sound -----------------------
    if (curTrackRattleSample < trackRattleSampleCount - 1)
    {
      g = (trackRattleSamples[curTrackRattleSample] * trackRattleVolumePercentage / 100 * trackRattleVolume / 100);
      curTrackRattleSample++;
    }
    else
    {
      curTrackRattleSample = 0;
    }
#endif

    if (!engineOn)
    {
      speedPercentage = 100;
      attenuator = 1;
      engineState = STOPPING;
      engineStop = true;
      engineRunning = false;
    }
    break;

  case STOPPING:                                                       // Engine stop --------------------------------------------------------------------
    variableTimerTicks = 4000000 / sampleRate * speedPercentage / 100; // our fixed sampling rate
    timerAlarmWrite(variableTimer, variableTimerTicks, true);          // // change timer ticks, autoreload true

    if (curEngineSample < sampleCount - 1)
    {
      a = (samples[curEngineSample] * throttleDependentVolume / 100 * idleVolumePercentage / 100 / attenuator);
      curEngineSample++;
    }
    else
    {
      curEngineSample = 0;
    }

    // fade engine sound out
    if (millis() - attenuatorMillis > 100)
    { // Every 50ms
      attenuatorMillis = millis();
      attenuator++;          // attenuate volume
      speedPercentage += 20; // make it slower (10)
    }

    if (attenuator >= 50 || speedPercentage >= 500)
    { // 50 & 500
      a = 0;
      speedPercentage = 100;
      parkingBrakeTrigger = true;
      engineState = PARKING_BRAKE;
      engineStop = false;
    }
    break;

  case PARKING_BRAKE: // parking brake bleeding air sound after engine is off ----------------------------

    if (!parkingBrakeTrigger)
    {
      engineState = OFF;
    }
    break;

  } // end of switch case

  // DAC output (groups a, b, c mixed together) ************************************************************************

  dacWrite(DAC1, constrain(((a * 8 / 10) + (b / 2) + (c / 5) + (d / 5) + (e / 5) + f + g) * masterVolume / 100 + dacOffset, 0, 255)); // Mix signals, add 128 offset, write  to DAC
  // dacWrite(DAC1, constrain(a * masterVolume / 100 + dacOffset, 0, 255));
  // dacWrite(DAC1, constrain(a + 128, 0, 255));

  // portEXIT_CRITICAL_ISR(&variableTimerMux);
}

//
// =======================================================================================================
// INTERRUPT FOR FIXED SPEED PLAYBACK (Horn etc., played in parallel with engine sound)
// =======================================================================================================
//

void IRAM_ATTR fixedPlaybackTimer()
{

  // coreId = xPortGetCoreID(); // Running on core 1

  static uint32_t curHornSample = 0;                            // Index of currently loaded horn sample
  static uint32_t curSirenSample = 0;                           // Index of currently loaded siren sample
  static uint32_t curSound1Sample = 0;                          // Index of currently loaded sound1 sample
  static uint32_t curReversingSample = 0;                       // Index of currently loaded reversing beep sample
  static uint32_t curIndicatorSample = 0;                       // Index of currently loaded indicator tick sample
  static uint32_t curWastegateSample = 0;                       // Index of currently loaded wastegate sample
  static uint32_t curBrakeSample = 0;                           // Index of currently loaded brake sound sample
  static uint32_t curParkingBrakeSample = 0;                    // Index of currently loaded brake sound sample
  static uint32_t curShiftingSample = 0;                        // Index of currently loaded shifting sample
  static uint32_t curDieselKnockSample = 0;                     // Index of currently loaded Diesel knock sample
  static uint32_t curCouplingSample = 0;                        // Index of currently loaded trailer coupling sample
  static uint32_t curUncouplingSample = 0;                      // Index of currently loaded trailer uncoupling sample
  static uint32_t curHydraulicFlowSample = 0;                   // Index of currently loaded hydraulic flow sample
  static uint32_t curTrackRattleSample = 0;                     // Index of currently loaded track rattle sample
  static uint32_t curBucketRattleSample = 0;                    // Index of currently loaded bucket rattle sample
  static uint32_t curTireSquealSample = 0;                      // Index of currently loaded tire squeal sample
  static uint32_t curOutOfFuelSample = 0;                       // Index of currently loaded out of fuel sample
  static int32_t a, a1, a2 = 0;                                 // Input signals "a" for mixer
  static int32_t b, b0, b1, b2, b3, b4, b5, b6, b7, b8, b9 = 0; // Input signals "b" for mixer
  static int32_t c, c1, c2, c3 = 0;                             // Input signals "c" for mixer
  static int32_t d, d1, d2 = 0;                                 // Input signals "d" for mixer
  static boolean knockSilent = 0;                               // This knock will be more silent
  static boolean knockMedium = 0;                               // This knock will be medium
  static uint8_t curKnockCylinder = 0;                          // Index of currently ignited zylinder

  // portENTER_CRITICAL_ISR(&fixedTimerMux);

  // Group "a" (horn & siren) ******************************************************************

  if (hornTrigger || hornLatch)
  {
    fixedTimerTicks = 4000000 / hornSampleRate;         // our fixed sampling rate
    timerAlarmWrite(fixedTimer, fixedTimerTicks, true); // // change timer ticks, autoreload true

    if (curHornSample < hornSampleCount - 1)
    {
      a1 = (hornSamples[curHornSample] * hornVolumePercentage / 100);
      curHornSample++;
#ifdef HORN_LOOP // Optional "endless loop" (points to be defined manually in horn file)
      if (hornTrigger && curHornSample == hornLoopEnd)
        curHornSample = hornLoopBegin; // Loop, if trigger still present
#endif
    }
    else
    { // End of sample
      curHornSample = 0;
      a1 = 0;
      hornLatch = false;
    }
  }

  if (sirenTrigger || sirenLatch)
  {
    fixedTimerTicks = 4000000 / sirenSampleRate;        // our fixed sampling rate
    timerAlarmWrite(fixedTimer, fixedTimerTicks, true); // // change timer ticks, autoreload true

#if defined SIREN_STOP
    if (!sirenTrigger)
    {
      sirenLatch = false;
      curSirenSample = 0;
      a2 = 0;
    }
#endif

    if (curSirenSample < sirenSampleCount - 1)
    {
      a2 = (sirenSamples[curSirenSample] * sirenVolumePercentage / 100);
      curSirenSample++;
#ifdef SIREN_LOOP // Optional "endless loop" (points to be defined manually in siren file)
      if (sirenTrigger && curSirenSample == sirenLoopEnd)
        curSirenSample = sirenLoopBegin; // Loop, if trigger still present
#endif
    }
    else
    { // End of sample
      curSirenSample = 0;
      a2 = 0;
      sirenLatch = false;
    }
  }
  if (curSirenSample > 10 && curSirenSample < 500)
    cannonFlash = true; // Tank cannon flash triggering in TRACKED_MODE
  else
    cannonFlash = false;

  // Group "b" (other sounds) **********************************************************************

  // Sound 1 "b0" ----
  if (sound1trigger)
  {
    fixedTimerTicks = 4000000 / sound1SampleRate;       // our fixed sampling rate
    timerAlarmWrite(fixedTimer, fixedTimerTicks, true); // // change timer ticks, autoreload true

    if (curSound1Sample < sound1SampleCount - 1)
    {
      b0 = (sound1Samples[curSound1Sample] * sound1VolumePercentage / 100);
      curSound1Sample++;
    }
    else
    {
      sound1trigger = false;
    }
  }
  else
  {
    curSound1Sample = 0; // ensure, next sound will start @ first sample
    b0 = 0;
  }

  // Reversing beep sound "b1" ----
  if (engineRunning && escInReverse)
  {
    fixedTimerTicks = 4000000 / reversingSampleRate;    // our fixed sampling rate
    timerAlarmWrite(fixedTimer, fixedTimerTicks, true); // // change timer ticks, autoreload true

    if (curReversingSample < reversingSampleCount - 1)
    {
      b1 = (reversingSamples[curReversingSample] * reversingVolumePercentage / 100);
      curReversingSample++;
    }
    else
    {
      curReversingSample = 0;
    }
  }
  else
  {
    curReversingSample = 0; // ensure, next sound will start @ first sample
    b1 = 0;
  }

  // Indicator tick sound "b2" ----------------------------------------------------------------------
#if not defined NO_INDICATOR_SOUND
  if (indicatorSoundOn)
  {
    fixedTimerTicks = 4000000 / indicatorSampleRate;    // our fixed sampling rate
    timerAlarmWrite(fixedTimer, fixedTimerTicks, true); // // change timer ticks, autoreload true

    if (curIndicatorSample < indicatorSampleCount - 1)
    {
      b2 = (indicatorSamples[curIndicatorSample] * indicatorVolumePercentage / 100);
      curIndicatorSample++;
    }
    else
    {
      indicatorSoundOn = false;
    }
  }
  else
  {
    curIndicatorSample = 0; // ensure, next sound will start @ first sample
    b2 = 0;
  }
#endif

  // Wastegate (blowoff) sound, triggered after rapid throttle drop -----------------------------------
  if (wastegateTrigger)
  {
    if (curWastegateSample < wastegateSampleCount - 1)
    {
      b3 = (wastegateSamples[curWastegateSample] * rpmDependentWastegateVolume / 100 * wastegateVolumePercentage / 100);
      curWastegateSample++;
    }
    else
    {
      wastegateTrigger = false;
    }
  }
  else
  {
    b3 = 0;
    curWastegateSample = 0; // ensure, next sound will start @ first sample
  }

  // Air brake release sound, triggered after stop -----------------------------------------------
  if (airBrakeTrigger)
  {
    if (curBrakeSample < brakeSampleCount - 1)
    {
      b4 = (brakeSamples[curBrakeSample] * brakeVolumePercentage / 100);
      curBrakeSample++;
    }
    else
    {
      airBrakeTrigger = false;
    }
  }
  else
  {
    b4 = 0;
    curBrakeSample = 0; // ensure, next sound will start @ first sample
  }

  // Air parking brake attaching sound, triggered after engine off --------------------------------
  if (parkingBrakeTrigger)
  {
    if (curParkingBrakeSample < parkingBrakeSampleCount - 1)
    {
      b5 = (parkingBrakeSamples[curParkingBrakeSample] * parkingBrakeVolumePercentage / 100);
      curParkingBrakeSample++;
    }
    else
    {
      parkingBrakeTrigger = false;
    }
  }
  else
  {
    b5 = 0;
    curParkingBrakeSample = 0; // ensure, next sound will start @ first sample
  }

  // Pneumatic gear shifting sound, triggered while shifting the TAMIYA 3 speed transmission ------
  if (shiftingTrigger && engineRunning && !automatic && !doubleClutch)
  {
    if (curShiftingSample < shiftingSampleCount - 1)
    {
      b6 = (shiftingSamples[curShiftingSample] * shiftingVolumePercentage / 100);
      curShiftingSample++;
    }
    else
    {
      shiftingTrigger = false;
    }
  }
  else
  {
    b6 = 0;
    curShiftingSample = 0; // ensure, next sound will start @ first sample
  }

  // Diesel ignition "knock" is played in fixed sample rate section, because we don't want changing pitch! ------
  if (dieselKnockTriggerFirst)
  {
    dieselKnockTriggerFirst = false;
    curKnockCylinder = 0;
  }

  if (dieselKnockTrigger)
  {
    dieselKnockTrigger = false;
    curKnockCylinder++; // Count ignition sequence
    curDieselKnockSample = 0;
  }

#ifdef V8 // (former ADAPTIVE_KNOCK_VOLUME, rename it in your config file!)
  // Ford or Scania V8 ignition sequence: 1 - 5 - 4 - 2* - 6 - 3 - 7 - 8* (* = louder knock pulses, because 2nd exhaust in same manifold after 90°)
  if (curKnockCylinder == 4 || curKnockCylinder == 8)
    knockSilent = false;
  else
    knockSilent = true;
#endif

#ifdef V8_MEDIUM // (former ADAPTIVE_KNOCK_VOLUME, rename it in your config file!)
  // This is EXPERIMENTAL!! TODO
  if (curKnockCylinder == 5 || curKnockCylinder == 1)
    knockMedium = false;
  else
    knockMedium = true;
#endif

#ifdef V8_468 // (Chevy 468, containing 16 ignition pulses)
  // 1th, 5th, 9th and 13th are the loudest
  // Ignition sequence: 1 - 8 - 4* - 3 - 6 - 5 - 7* - 2
  if (curKnockCylinder == 1 || curKnockCylinder == 5 || curKnockCylinder == 9 || curKnockCylinder == 13)
    knockSilent = false;
  else
    knockSilent = true;
#endif

#ifdef V2
  // V2 engine: 1st and 2nd knock pulses (of 4) will be louder
  if (curKnockCylinder == 1 || curKnockCylinder == 2)
    knockSilent = false;
  else
    knockSilent = true;
#endif

#ifdef R6
  // R6 inline 6 engine: 6th knock pulse (of 6) will be louder
  if (curKnockCylinder == 6)
    knockSilent = false;
  else
    knockSilent = true;
#endif

#ifdef R6_2
  // R6 inline 6 engine: 6th and 3rd knock pulse (of 6) will be louder
  if (curKnockCylinder == 6 || curKnockCylinder == 3)
    knockSilent = false;
  else
    knockSilent = true;
#endif

  if (curDieselKnockSample < knockSampleCount)
  {
#if defined RPM_DEPENDENT_KNOCK // knock volume also depending on engine rpm
    b7 = (knockSamples[curDieselKnockSample] * dieselKnockVolumePercentage / 100 * throttleDependentKnockVolume / 100 * rpmDependentKnockVolume / 100);
#elif defined EXCAVATOR_MODE // knock volume also depending on hydraulic load
    b7 = (knockSamples[curDieselKnockSample] * dieselKnockVolumePercentage / 100 * throttleDependentKnockVolume / 100 * hydraulicDependentKnockVolume / 100);
#else                        // Just depending on throttle
    b7 = (knockSamples[curDieselKnockSample] * dieselKnockVolumePercentage / 100 * throttleDependentKnockVolume / 100);
#endif
    curDieselKnockSample++;
    if (knockSilent && !knockMedium)
      b7 = b7 * dieselKnockAdaptiveVolumePercentage / 100; // changing knock volume according to engine type and cylinder!
    if (knockMedium)
      b7 = b7 * dieselKnockAdaptiveVolumePercentage / 75;
  }

#if not defined EXCAVATOR_MODE
  // Trailer coupling sound, triggered by switch -----------------------------------------------
#ifdef COUPLING_SOUND
  if (couplingTrigger)
  {
    if (curCouplingSample < couplingSampleCount - 1)
    {
      b8 = (couplingSamples[curCouplingSample] * couplingVolumePercentage / 100);
      curCouplingSample++;
    }
    else
    {
      couplingTrigger = false;
    }
  }
  else
  {
    b8 = 0;
    curCouplingSample = 0; // ensure, next sound will start @ first sample
  }

  // Trailer uncoupling sound, triggered by switch -----------------------------------------------
  if (uncouplingTrigger)
  {
    if (curUncouplingSample < uncouplingSampleCount - 1)
    {
      b9 = (uncouplingSamples[curUncouplingSample] * couplingVolumePercentage / 100);
      curUncouplingSample++;
    }
    else
    {
      uncouplingTrigger = false;
    }
  }
  else
  {
    b9 = 0;
    curUncouplingSample = 0; // ensure, next sound will start @ first sample
  }
#endif
#endif

  // Group "c" (excavator sounds) **********************************************************************

#if defined EXCAVATOR_MODE

  // Hydraulic fluid flow sound -----------------------
  if (curHydraulicFlowSample < hydraulicFlowSampleCount - 1)
  {
    c1 = (hydraulicFlowSamples[curHydraulicFlowSample] * hydraulicFlowVolumePercentage / 100 * hydraulicFlowVolume / 100);
    curHydraulicFlowSample++;
  }
  else
  {
    curHydraulicFlowSample = 0;
  }

  // Track rattle sound -----------------------
  if (curTrackRattleSample < trackRattleSampleCount - 1)
  {
    c2 = (trackRattleSamples[curTrackRattleSample] * trackRattleVolumePercentage / 100 * trackRattleVolume / 100);
    curTrackRattleSample++;
  }
  else
  {
    curTrackRattleSample = 0;
  }

  // Bucket rattle sound -----------------------
  if (bucketRattleTrigger)
  {
    if (curBucketRattleSample < bucketRattleSampleCount - 1)
    {
      c3 = (bucketRattleSamples[curBucketRattleSample] * bucketRattleVolumePercentage / 100);
      curBucketRattleSample++;
    }
    else
    {
      bucketRattleTrigger = false;
    }
  }
  else
  {
    c3 = 0;
    curBucketRattleSample = 0; // ensure, next sound will start @ first sample
  }
#endif

  // Group "d" (additional sounds) **********************************************************************

#if defined TIRE_SQUEAL
  // Tire squeal sound -----------------------
  if (curTireSquealSample < tireSquealSampleCount - 1)
  {
    d1 = (tireSquealSamples[curTireSquealSample] * tireSquealVolumePercentage / 100 * tireSquealVolume / 100);
    curTireSquealSample++;
  }
  else
  {
    d1 = 0;
    curTireSquealSample = 0;
  }
#endif

#if defined BATTERY_PROTECTION
  // Out of fuel sound, triggered by battery voltage -----------------------------------------------
  if (outOfFuelMessageTrigger)
  {
    if (curOutOfFuelSample < outOfFuelSampleCount - 1)
    {
      d2 = (outOfFuelSamples[curOutOfFuelSample] * outOfFuelVolumePercentage / 100);
      curOutOfFuelSample++;
    }
    else
    {
      outOfFuelMessageTrigger = false;
    }
  }
  else
  {
    d2 = 0;
    curOutOfFuelSample = 0; // ensure, next sound will start @ first sample
  }
#endif

  // Mixing sounds together **********************************************************************
  a = a1 + a2; // Horn & siren
  // if (a < 2 && a > -2) a = 0; // Remove noise floor TODO, experimental
  b = b0 * 5 + b1 + b2 / 2 + b3 + b4 + b5 + b6 + b7 + b8 + b9; // Other sounds
  c = c1 + c2 + c3;                                            // Excavator sounds
  d = d1 + d2;                                                 // Additional sounds

  // DAC output (groups mixed together) ****************************************************************************

  // dacDebug = constrain(((a * 8 / 10) + (b * 2 / 10) + c + d) * masterVolume / 100 + dacOffset, 0, 255); // Mix signals, add 128 offset, write result to DAC
  dacWrite(DAC2, constrain(((a * 8 / 10) + (b * 2 / 10) + c + d) * masterVolume / 100 + dacOffset, 0, 255)); // Mix signals, add 128 offset, write result to DAC
  // dacWrite(DAC2, constrain( a2 * masterVolume / 100 + dacOffset, 0, 255)); // Mix signals, add 128 offset, write result to DAC
  // dacWrite(DAC2, 0);

  // portEXIT_CRITICAL_ISR(&fixedTimerMux);
}

//
// =======================================================================================================
// PWM SIGNAL READ INTERRUPT
// =======================================================================================================
//

// Reference https://docs.espressif.com/projects/esp-idf/en/latest/esp32/api-reference/peripherals/rmt.html?highlight=rmt
static void IRAM_ATTR rmt_isr_handler(void *arg)
{

  uint32_t intr_st = RMT.int_st.val;

  static uint32_t lastFrameTime = millis();

  if (millis() - lastFrameTime > 20)
  { // Only do it every 20ms (very important for system stability)

    // See if we can obtain or "Take" the Semaphore.
    // If the semaphore is not available, wait 1 ticks of the Scheduler to see if it becomes free.
    if (xSemaphoreTake(xPwmSemaphore, portMAX_DELAY))
    {
      // We were able to obtain or "Take" the semaphore and can now access the shared resource.
      // We want to have the pwmBuf variable for us alone,
      // so we don't want it getting stolen during the middle of a conversion.

      uint8_t i;
      for (i = 0; i < PWM_CHANNELS_NUM; i++)
      {
        uint8_t channel = PWM_CHANNELS[i];
        uint32_t channel_mask = BIT(channel * 3 + 1);

        if (!(intr_st & channel_mask))
          continue;

        RMT.conf_ch[channel].conf1.rx_en = 0;
        RMT.conf_ch[channel].conf1.mem_owner = RMT_MEM_OWNER_TX;
        volatile rmt_item32_t *item = RMTMEM.chan[channel].data32;

        if (item)
        {
          pwmBuf[i + 1] = item->duration0; // pointer -> variable
        }

        RMT.conf_ch[channel].conf1.mem_wr_rst = 1;
        RMT.conf_ch[channel].conf1.mem_owner = RMT_MEM_OWNER_RX;
        RMT.conf_ch[channel].conf1.rx_en = 1;

        // clear RMT interrupt status.
        RMT.int_clr.val = channel_mask;
      }

      xSemaphoreGive(xPwmSemaphore); // Now free or "Give" the semaphore for others.
    }
    lastFrameTime = millis();
  }
  else
  {
    xSemaphoreGive(xPwmSemaphore); // Free or "Give" the semaphore for others, if not required!
  }
}

//
// =======================================================================================================
// PPM SIGNAL READ INTERRUPT
// =======================================================================================================
//

void IRAM_ATTR readPpm()
{
  unsigned long timenew = micros();
  unsigned long timediff = timenew - timelast;
  timelast = timenew;

  if (timediff > 2500)
  {                                                             // Synch gap detected:
    ppmInp[NUM_OF_PPM_CHL] = ppmInp[NUM_OF_PPM_CHL] + timediff; // add time
    counter = 0;
    if (average == NUM_OF_PPM_AVG)
    {
      for (int i = 0; i < NUM_OF_PPM_CHL + 1; i++)
      {
        ppmBuf[i] = ppmInp[i] / average;
        ppmInp[i] = 0;
      }
      average = 0;
      ready = true;
    }
    average++;
  }
  else
  {
    if (counter < NUM_OF_PPM_CHL)
    {
      ppmInp[counter] = ppmInp[counter] + timediff;
      counter++;
    }
  }
}

//
// =======================================================================================================
// TRAILER PRESENCE SWITCH INTERRUPT (not usable with third brake light or RZ7886 motor driver)
// =======================================================================================================
//
#if not defined THIRD_BRAKELIGHT and not defined RZ7886_DRIVER_MODE
void IRAM_ATTR trailerPresenceSwitchInterrupt()
{
  couplerSwitchInteruptLatch = true;
}
#endif

//
// =======================================================================================================
// mcpwm unit 0 SETUP for servos (1x during startup)
// =======================================================================================================
//
// See: https://docs.espressif.com/projects/esp-idf/en/latest/esp32/api-reference/peripherals/mcpwm.html#configure

void setupMcpwm()
{
  // 1. set our servo output pins
  mcpwm_gpio_init(MCPWM_UNIT_0, MCPWM0A, STEERING_PIN); // Set steering as PWM0A
  mcpwm_gpio_init(MCPWM_UNIT_0, MCPWM0B, SHIFTING_PIN); // Set shifting as PWM0B
  mcpwm_gpio_init(MCPWM_UNIT_0, MCPWM1A, COUPLER_PIN);  // Set coupling as PWM1A
  mcpwm_gpio_init(MCPWM_UNIT_0, MCPWM1B, WINCH_PIN);    // Set winch  or beacon as PWM1B

  // 2. configure MCPWM parameters
  mcpwm_config_t pwm_config;
  pwm_config.frequency = SERVO_FREQUENCY; // frequency usually = 50Hz, some servos may run smoother @ 100Hz
  pwm_config.cmpr_a = 0;                  // duty cycle of PWMxa = 0
  pwm_config.cmpr_b = 0;                  // duty cycle of PWMxb = 0
  pwm_config.counter_mode = MCPWM_UP_COUNTER;
  pwm_config.duty_mode = MCPWM_DUTY_MODE_0; // 0 = not inverted, 1 = inverted

  // 3. configure channels with settings above
  mcpwm_init(MCPWM_UNIT_0, MCPWM_TIMER_0, &pwm_config); // Configure PWM0A & PWM0B
  mcpwm_init(MCPWM_UNIT_0, MCPWM_TIMER_1, &pwm_config); // Configure PWM1A & PWM1B
}

//
// =======================================================================================================
// mcpwm unit 1 SETUP for ESC (1x during startup)
// =======================================================================================================
//
// See: https://docs.espressif.com/projects/esp-idf/en/latest/esp32/api-reference/peripherals/mcpwm.html#configure

void setupMcpwmESC()
{
#if not defined RZ7886_DRIVER_MODE // Setup for classic crawler style RC ESC ----
  Serial.printf("Standard ESC mode configured. Connect crawler ESC to ESC header. RZ7886 motor driver not usable!\n");

  // 1. set our ESC output pin
  mcpwm_gpio_init(MCPWM_UNIT_1, MCPWM0A, ESC_OUT_PIN); // Set ESC as PWM0A

  // 2. configure MCPWM parameters
  mcpwm_config_t pwm_config;
  pwm_config.frequency = 50; // frequency always 50Hz
  pwm_config.cmpr_a = 0;     // duty cycle of PWMxa = 0
  pwm_config.cmpr_b = 0;     // duty cycle of PWMxb = 0
  pwm_config.counter_mode = MCPWM_UP_COUNTER;
  pwm_config.duty_mode = MCPWM_DUTY_MODE_0; // 0 = not inverted, 1 = inverted

  // 3. configure channels with settings above
  mcpwm_init(MCPWM_UNIT_1, MCPWM_TIMER_0, &pwm_config); // Configure PWM0A & PWM0B

#else // Setup for RZ7886 motor driver ----
  Serial.printf("RZ7886 motor driver mode configured. Don't connect ESC to ESC header!\n");

  // 1. set our ESC output pin
  mcpwm_gpio_init(MCPWM_UNIT_1, MCPWM0A, RZ7886_PIN1); // Set RZ7886 pin 1 as PWM0A
  mcpwm_gpio_init(MCPWM_UNIT_1, MCPWM0B, RZ7886_PIN2); // Set RZ7886 pin 2 as PWM0B

  // 2. configure MCPWM parameters
  mcpwm_config_t pwm_config;
  pwm_config.frequency = RZ7886_FREQUENCY; // frequency
  pwm_config.cmpr_a = 0;                   // duty cycle of PWMxa = 0
  pwm_config.cmpr_b = 0;                   // duty cycle of PWMxb = 0
  pwm_config.counter_mode = MCPWM_UP_COUNTER;
  pwm_config.duty_mode = MCPWM_DUTY_MODE_0; // 0 = not inverted, 1 = inverted

  // 3. configure channels with settings above
  mcpwm_init(MCPWM_UNIT_1, MCPWM_TIMER_0, &pwm_config); // Configure PWM0A & PWM0B
#endif
  Serial.printf("-------------------------------------\n");
}

//
// =======================================================================================================
// ESP NOW SETUP FOR WIRELESS TRAILER CONTROL
// =======================================================================================================
//

void setupEspNow()
{

#if defined ENABLE_WIRELESS
  Serial.printf("ENABLE_WIRELESS option enabled\n");
  // Serial.printf("Sound controller MAC address: %s\n", WiFi.macAddress().c_str());
  //  Set device as a Wi-Fi Station for ESP-NOW
  WiFi.mode(WIFI_STA); // WIFI_STA = Station

  // Set IP address
  IPAddress IP = WiFi.softAPIP();

  Serial.printf("\nInformations for web configuration via your cell phone or computer *******************************\n");
  Serial.print("SSID: ");
  Serial.println(ssid);
  Serial.print("Password: ");
  Serial.println(password);
  Serial.print("IP address: ");
  Serial.println(IP);

  // shut down wifi
  WiFi.disconnect();

  // Start access point
  WiFi.softAP(ssid.c_str(), password.c_str());

  Serial.printf("\nWiFi Tx Power Level: %u", WiFi.getTxPower());
  WiFi.setTxPower(cpType); // WiFi and ESP-Now power according to "0_generalSettings.h"
  Serial.printf("\nWiFi Tx Power Level changed to: %u\n\n", WiFi.getTxPower());

  server.begin(); // Start Webserver

  // Init ESP-NOW
  if (esp_now_init() != ESP_OK)
  {
    Serial.printf("Error initializing ESP-NOW!\n");
    return;
  }

  // Register callback function to call when data was sent (used only for debug for now)
  esp_now_register_send_cb(onTrailerDataSent); // TODO, optional

  // Register peer
  peerInfo.channel = 0;
  peerInfo.encrypt = false;

  Serial.printf("The following trailers are currently enabled:\n");
  // Add peer 1 (1st trailer)
  if (useTrailer1)
  {
    memcpy(peerInfo.peer_addr, broadcastAddress1, 6); // TODO!
    Serial.printf("Trailer 1 MAC address: %02X:%02X:%02X:%02X:%02X:%02X\n", broadcastAddress1[0], broadcastAddress1[1], broadcastAddress1[2], broadcastAddress1[3], broadcastAddress1[4], broadcastAddress1[5]);
    if (esp_now_add_peer(&peerInfo) != ESP_OK)
    {
      Serial.printf("Failed to add peer #1 (1st trailer)\n");
      return;
    }
  }

  // Add peer 2 (2nd trailer)
  if (useTrailer2)
  {
    memcpy(peerInfo.peer_addr, broadcastAddress2, 6);
    Serial.printf("Trailer 2 MAC address: %02X:%02X:%02X:%02X:%02X:%02X\n", broadcastAddress2[0], broadcastAddress2[1], broadcastAddress2[2], broadcastAddress2[3], broadcastAddress2[4], broadcastAddress2[5]);
    if (esp_now_add_peer(&peerInfo) != ESP_OK)
    {
      Serial.printf("Failed to add peer #2 (2nd trailer)\n");
      return;
    }
  }

  // Add peer 3 (3rd trailer)
  if (useTrailer3)
  {
    memcpy(peerInfo.peer_addr, broadcastAddress3, 6);
    Serial.printf("Trailer 3 MAC address: %02X:%02X:%02X:%02X:%02X:%02X\n", broadcastAddress3[0], broadcastAddress3[1], broadcastAddress3[2], broadcastAddress3[3], broadcastAddress3[4], broadcastAddress3[5]);
    if (esp_now_add_peer(&peerInfo) != ESP_OK)
    {
      Serial.printf("Failed to add peer #3 (3rd trailer)\n");
      return;
    }
  }
#else
  Serial.printf("ENABLE_WIRELESS option disabled, no WiFi configuration or ESP-Now Trailer!\n");
#endif // ENABLE_WIRELESS
  Serial.printf("-------------------------------------\n");
}

//
// =======================================================================================================
// BATTERY SETUP
// =======================================================================================================
//

void setupBattery()
{
#if defined BATTERY_PROTECTION

  Serial.printf("Battery voltage: %.2f V\n", batteryVolts());
  Serial.printf("Cutoff voltage per cell: %.2f V\n", CUTOFF_VOLTAGE);
  Serial.printf("Fully charged voltage per cell: %.2f V\n", FULLY_CHARGED_VOLTAGE);

#define CELL_SETPOINT (CUTOFF_VOLTAGE - ((FULLY_CHARGED_VOLTAGE - CUTOFF_VOLTAGE) / 2))

  if (batteryVolts() <= CELL_SETPOINT * 2)
    numberOfCells = 1;
  if (batteryVolts() > CELL_SETPOINT * 2)
    numberOfCells = 2;
  if (batteryVolts() > CELL_SETPOINT * 3)
    numberOfCells = 3;
  if (batteryVolts() > FULLY_CHARGED_VOLTAGE * 3)
    numberOfCells = 4;
  batteryCutoffvoltage = CUTOFF_VOLTAGE * numberOfCells; // Calculate cutoff voltage for battery protection
  if (numberOfCells > 1 && numberOfCells < 4)
  { // Only 2S & 3S batteries are supported!
    Serial.printf("Number of cells: %i (%iS battery detected) Based on setpoint: %.2f V\n", numberOfCells, numberOfCells, (CELL_SETPOINT * numberOfCells));
    Serial.printf("Battery cutoff voltage: %.2f V (%i * %.2f V) \n", batteryCutoffvoltage, numberOfCells, CUTOFF_VOLTAGE);
    for (uint8_t beeps = 0; beeps < numberOfCells; beeps++)
    { // Number of beeps = number of cells in series
      tone(26, 3000, 4, 0);
      // tone(26, 3000, 4); // For platform = espressif32@4.3.0
      delay(200);
    }
  }
  else
  {
    Serial.printf("Error, no valid battery detected! Only 2S & 3S batteries are supported!\n");
    Serial.printf("REMOVE BATTERY, CONTROLLER IS LOCKED = 2 FAST FLASHES!\n");
    bool locked = true;
    for (uint8_t beeps = 0; beeps < 10; beeps++)
    { // Number of beeps = number of cells in series
      tone(26, 3000, 4, 0);
      // tone(26, 3000, 4); // For platform = espressif32@4.3.0
      delay(30);
    }
    while (locked)
    {
      // wait here forever!
      indicatorL.flash(70, 75, 500, 2); // Show 2 fast flashes on indicators!
      indicatorR.flash(70, 75, 500, 2);
      rtc_wdt_feed(); // Feed watchdog timer
    }
  }
#else
  Serial.printf("Warning, BATTERY_PROTECTION disabled! ESC with low discharge protection required!\n");
#endif
  Serial.printf("-------------------------------------\n");
}

//
// =======================================================================================================
// EEPROM SETUP
// =======================================================================================================
//

void setupEeprom()
{
  EEPROM.begin(EEPROM_SIZE);
#if defined ERASE_EEPROM_ON_BOOT
  eepromErase(); // uncomment this option, if you want to erase all stored settings!
#endif
  eepromInit(); // Init new board with default values
  eepromRead(); // Read settings from Eeprom
  Serial.print("current eeprom_id: ");
  Serial.println(EEPROM.read(adr_eprom_init));
  Serial.println("change it for default value upload!\n");
  eepromDebugRead(); // Shows content of entire eeprom, except of empty areas
}

//
// =======================================================================================================
// MAIN ARDUINO SETUP (1x during startup)
// =======================================================================================================
//
#ifdef bp32
GamepadPtr myGamepads[BP32_MAX_GAMEPADS];

// This callback gets called any time a new gamepad is connected.
// Up to 4 gamepads can be connected at the same time.
void onConnectedGamepad(GamepadPtr gp) {
  bool foundEmptySlot = false;
  for (int i = 0; i < BP32_MAX_GAMEPADS; i++) {
    if (myGamepads[i] == nullptr) {
      Serial.printf("CALLBACK: Gamepad is connected, index=%d\n", i);
      // Additionally, you can get certain gamepad properties like:
      // Model, VID, PID, BTAddr, flags, etc.
      GamepadProperties properties = gp->getProperties();
      Serial.printf("Gamepad model: %s, VID=0x%04x, PID=0x%04x\n",
                    gp->getModelName().c_str(), properties.vendor_id,
                    properties.product_id);
      myGamepads[i] = gp;
      foundEmptySlot = true;
      break;
    }
  }
  if (!foundEmptySlot) {
    Serial.println(
        "CALLBACK: Gamepad connected, but could not found empty slot");
  }
}

void onDisconnectedGamepad(GamepadPtr gp) {
  bool foundGamepad = false;

  for (int i = 0; i < BP32_MAX_GAMEPADS; i++) {
    if (myGamepads[i] == gp) {
      Serial.printf("CALLBACK: Gamepad is disconnected from index=%d\n", i);
      myGamepads[i] = nullptr;
      foundGamepad = true;
      break;
    }
  }

  if (!foundGamepad) {
    Serial.println(
        "CALLBACK: Gamepad disconnected, but not found in myGamepads");
  }
}
#endif
void setup()
{
  // Watchdog timers need to be disabled, if task 1 is running without delay(1)
  disableCore0WDT();
  // disableCore1WDT(); // Core 1 WDT can stay enabled TODO

  // Setup RTC (Real Time Clock) watchdog
  rtc_wdt_protect_off(); // Disable RTC WDT write protection
  rtc_wdt_set_length_of_reset_signal(RTC_WDT_SYS_RESET_SIG, RTC_WDT_LENGTH_3_2us);
  rtc_wdt_set_stage(RTC_WDT_STAGE0, RTC_WDT_STAGE_ACTION_RESET_SYSTEM);
  rtc_wdt_set_time(RTC_WDT_STAGE0, 10000); // set 10s timeout
  rtc_wdt_enable();                        // Start the RTC WDT timer
  // rtc_wdt_disable();            // Disable the RTC WDT timer
  rtc_wdt_protect_on(); // Enable RTC WDT write protection

  // Serial setup
  Serial.begin(115200, SERIAL_8N1, DEBUG_RX, DEBUG_TX); // USB serial (for DEBUG) Mode, Rx pin (99 = not used), Tx pin

  // ADC setup
  //battery.attach(BATTERY_DETECT_PIN);
  adcAttachPin(BATTERY_DETECT_PIN);

  // Print some system and software info to serial monitor
  delay(1000); // Give serial port/connection some time to get ready
  Serial.printf("\n**************************************************************************************************\n");
  Serial.printf("TheDIYGuy999 RC engine sound & light controller for ESP32 software version %s\n", codeVersion);
  Serial.printf("https://github.com/TheDIYGuy999/Rc_Engine_Sound_ESP32\n");
  Serial.printf("Please read carefully: https://github.com/TheDIYGuy999/Rc_Engine_Sound_ESP32/blob/master/README.md\n");
  Serial.printf("XTAL Frequency: %i MHz, CPU Clock: %i MHz, APB Bus Clock: %i Hz\n", getXtalFrequencyMhz(), getCpuFrequencyMhz(), getApbFrequency());
  Serial.printf("Internal RAM size: %i Byte, Free: %i Byte\n", ESP.getHeapSize(), ESP.getFreeHeap());
  for (uint8_t coreNum = 0; coreNum < 2; coreNum++)
  {
    uint8_t resetReason = rtc_get_reset_reason(coreNum);
    if (resetReason <= (sizeof(RESET_REASONS) / sizeof(RESET_REASONS[0])))
    {
      Serial.printf("Core %i reset reason: %i: %s\n", coreNum, rtc_get_reset_reason(coreNum), RESET_REASONS[resetReason - 1]);
    }
  }
#if defined BATTERY_PROTECTION
  Serial.printf("Battery protection calibration data:\n");
  Serial.printf("RESISTOR_TO_BATTTERY_PLUS: %i Ω\n", RESISTOR_TO_BATTTERY_PLUS);
  Serial.printf("RESISTOR_TO_GND: %i Ω\n", RESISTOR_TO_GND);
  Serial.printf("DIODE_DROP: %.2f V\n", DIODE_DROP);
#endif

  Serial.printf("**************************************************************************************************\n\n");

  // Eeprom Setup
  setupEeprom();

  // Semaphores are useful to stop a Task proceeding, where it should be paused to wait,
  // because it is sharing a resource, such as the PWM variable.
  // Semaphores should only be used whilst the scheduler is running, but we can set it up here.
  if (xPwmSemaphore == NULL) // Check to confirm that the PWM Semaphore has not already been created.
  {
    xPwmSemaphore = xSemaphoreCreateMutex(); // Create a mutex semaphore we will use to manage variable access
    if ((xPwmSemaphore) != NULL)
      xSemaphoreGive((xPwmSemaphore)); // Make the PWM variable available for use, by "Giving" the Semaphore.
  }

  if (xRpmSemaphore == NULL) // Check to confirm that the RPM Semaphore has not already been created.
  {
    xRpmSemaphore = xSemaphoreCreateMutex(); // Create a mutex semaphore we will use to manage variable access
    if ((xRpmSemaphore) != NULL)
      xSemaphoreGive((xRpmSemaphore)); // Make the RPM variable available for use, by "Giving" the Semaphore.
  }

  // Set pin modes
  pinMode(COMMAND_RX, INPUT_PULLDOWN);

#if not defined THIRD_BRAKELIGHT and not defined RZ7886_DRIVER_MODE // If a third brakelight is not defined and RZ7886 motor driver is not defined, pin 32 for the trailer presence switch
  pinMode(COUPLER_SWITCH_PIN, INPUT_PULLUP);
  attachInterrupt(digitalPinToInterrupt(COUPLER_SWITCH_PIN), trailerPresenceSwitchInterrupt, CHANGE);
#endif

  // LED & shaker motor setup (note, that we only have timers from 0 - 15, but 0 - 1 are used for interrupts!)
  headLight.begin(HEADLIGHT_PIN, 15, 20000);           // Timer 15, 20kHz
  tailLight.begin(TAILLIGHT_PIN, 2, 20000);            // Timer 2, 20kHz
  indicatorL.begin(INDICATOR_LEFT_PIN, 3, 20000);      // Timer 3, 20kHz
  indicatorR.begin(INDICATOR_RIGHT_PIN, 4, 20000);     // Timer 4, 20kHz
  fogLight.begin(FOGLIGHT_PIN, 5, 20000);              // Timer 5, 20kHz
  reversingLight.begin(REVERSING_LIGHT_PIN, 6, 20000); // Timer 6, 20kHz
  roofLight.begin(ROOFLIGHT_PIN, 7, 20000);            // Timer 7, 20kHz

#if not defined SPI_DASHBOARD
  sideLight.begin(SIDELIGHT_PIN, 8, 20000);         // Timer 8, 20kHz
  beaconLight1.begin(BEACON_LIGHT1_PIN, 9, 20000);  // Timer 9, 20kHz
  beaconLight2.begin(BEACON_LIGHT2_PIN, 10, 20000); // Timer 10, 20kHz
#endif

#if defined THIRD_BRAKELIGHT and not defined RZ7886_DRIVER_MODE
  brakeLight.begin(BRAKELIGHT_PIN, 11, 20000); // Timer 11, 20kHz
#endif
  cabLight.begin(CABLIGHT_PIN, 12, 20000); // Timer 12, 20kHz

#if not defined SPI_DASHBOARD
  shakerMotor.begin(SHAKER_MOTOR_PIN, 13, 20000); // Timer 13, 20kHz
#endif

  // Battery setup
  setupBattery();

  // ESP NOW setup
  setupEspNow();

#if defined SPI_DASHBOARD
  // Dashboard setup
  Serial.printf("SPI_DASHBOARD enabled. Pins 18 (sidelights), 19 (beacon2), 21 (beacon1), 23 (shaker) not usable!\n");
  Serial.printf("-------------------------------------\n");
  dashboard.init(dashRotation);
#endif

  // Neopixel setup
#ifdef NEOPIXEL_ENABLED
  FastLED.addLeds<NEOPIXEL, RGB_LEDS_PIN>(rgbLEDs, NEOPIXEL_COUNT);
  FastLED.setCorrection(TypicalLEDStrip);
  FastLED.setBrightness(NEOPIXEL_BRIGHTNESS);
  FastLED.setMaxPowerInVoltsAndMilliamps(5, MAX_POWER_MILLIAMPS);
#endif

  // Communication setup --------------------------------------------
  indicatorL.on();
  indicatorR.on();

#if defined SBUS_COMMUNICATION // SBUS ----
  if (MAX_RPM_PERCENTAGE > maxSbusRpmPercentage)
    MAX_RPM_PERCENTAGE = maxSbusRpmPercentage;                // Limit RPM range
  sBus.begin(COMMAND_RX, COMMAND_TX, sbusInverted, sbusBaud); // begin SBUS communication with compatible receivers
  setupMcpwm();                                               // mcpwm servo output setup

#elif defined IBUS_COMMUNICATION // IBUS ----
  if (MAX_RPM_PERCENTAGE > maxIbusRpmPercentage)
    MAX_RPM_PERCENTAGE = maxIbusRpmPercentage;                 // Limit RPM range
  iBus.begin(Serial2, IBUSBM_NOTIMER, COMMAND_RX, COMMAND_TX); // begin IBUS communication with compatible receivers
  setupMcpwm();                                                // mcpwm servo output setup

#elif defined PPM_COMMUNICATION // PPM ----
  if (MAX_RPM_PERCENTAGE > maxPpmRpmPercentage)
    MAX_RPM_PERCENTAGE = maxPpmRpmPercentage;                          // Limit RPM range
  attachInterrupt(digitalPinToInterrupt(COMMAND_RX), readPpm, RISING); // begin PPM communication with compatible receivers
  setupMcpwm();                                                        // mcpwm servo output setup

#elif defined SUMD_COMMUNICATION // Graupner SUMD ----
  // SUMD communication
  if (MAX_RPM_PERCENTAGE > maxSumdRpmPercentage)
    MAX_RPM_PERCENTAGE = maxSumdRpmPercentage; // Limit RPM range
  sumd.begin(COMMAND_RX);                      // begin SUMD communication with compatible receivers
  setupMcpwm();                                // mcpwm servo output setup

#else
  // PWM ----
#define PWM_COMMUNICATION
  if (MAX_RPM_PERCENTAGE > maxPwmRpmPercentage)
    MAX_RPM_PERCENTAGE = maxPwmRpmPercentage; // Limit RPM range
  for (uint8_t i = 0; i < PWM_CHANNELS_NUM; i++)
  {
    pinMode(PWM_PINS[i], INPUT_PULLDOWN);
  }
  // New: PWM read setup, using rmt. Thanks to croky-b
  uint8_t i;
  rmt_config_t rmt_channels[PWM_CHANNELS_NUM] = {};

  for (i = 0; i < PWM_CHANNELS_NUM; i++)
  {
    rmt_channels[i].channel = (rmt_channel_t)PWM_CHANNELS[i];
    rmt_channels[i].gpio_num = (gpio_num_t)PWM_PINS[i];
    rmt_channels[i].clk_div = RMT_RX_CLK_DIV;
    rmt_channels[i].mem_block_num = 1;
    rmt_channels[i].rmt_mode = RMT_MODE_RX;
    rmt_channels[i].rx_config.filter_en = true;
    rmt_channels[i].rx_config.filter_ticks_thresh = 100; // Pulses shorter than this will be filtered out
    rmt_channels[i].rx_config.idle_threshold = RMT_RX_MAX_US * RMT_TICK_PER_US;

    rmt_config(&rmt_channels[i]);
    rmt_set_rx_intr_en(rmt_channels[i].channel, true);
    rmt_rx_start(rmt_channels[i].channel, 1);
  }

  rmt_isr_register(rmt_isr_handler, NULL, 0, NULL); // This is our interrupt

#endif // -----------------------------------------------------------

  // Refresh sample intervals (important, because MAX_RPM_PERCENTAGE was probably changed above)
  maxSampleInterval = 4000000 / sampleRate;
  minSampleInterval = 4000000 / sampleRate * 100 / MAX_RPM_PERCENTAGE;

  // Time
  timelast = micros();
  timelastloop = timelast;

  // Task 1 setup (running on core 0)
  TaskHandle_t Task1;
  // create a task that will be executed in the Task1code() function, with priority 1 and executed on core 0
  xTaskCreatePinnedToCore(
      Task1code, // Task function
      "Task1",   // name of task
      8192,      // Stack size of task (8192)
      NULL,      // parameter of the task
      1,         // priority of the task (1 = low, 3 = medium, 5 = highest)
      &Task1,    // Task handle to keep track of created task
      1);        // pin task to core 0

  // Interrupt timer for variable sample rate playback
  variableTimer = timerBegin(0, 20, true);                           // timer 0, MWDT clock period = 12.5 ns * TIMGn_Tx_WDT_CLK_PRESCALE -> 12.5 ns * 20 -> 250 ns = 0.25 us, countUp
  timerAttachInterrupt(variableTimer, &variablePlaybackTimer, true); // edge (not level) triggered
  timerAlarmWrite(variableTimer, variableTimerTicks, true);          // autoreload true
  timerAlarmEnable(variableTimer);                                   // enable

  // Interrupt timer for fixed sample rate playback
  fixedTimer = timerBegin(1, 20, true);                        // timer 1, MWDT clock period = 12.5 ns * TIMGn_Tx_WDT_CLK_PRESCALE -> 12.5 ns * 20 -> 250 ns = 0.25 us, countUp
  timerAttachInterrupt(fixedTimer, &fixedPlaybackTimer, true); // edge (not level) triggered
  timerAlarmWrite(fixedTimer, fixedTimerTicks, true);          // autoreload true
  timerAlarmEnable(fixedTimer);                                // enable

  // wait for RC receiver to initialize
  while (millis() <= 1000)
    ;

    // Read RC signals for the first time (used for offset calculations)
#if defined SBUS_COMMUNICATION
  sbusInit = false;
  Serial.printf("Initializing SBUS (sbusInverted = %s, needs to be true for most standard radios) ...\n", sbusInverted ? "true" : "false");
  Serial.printf("(Make sure radio and receiver are connected, turned on, bound and configured for SBUS output.)\n");
  while (!sbusInit)
  {
    readSbusCommands();               // SBUS communication (pin 36)
    indicatorL.flash(70, 75, 500, 3); // Show 3 fast flashes on indicators!
    indicatorR.flash(70, 75, 500, 3);
    rtc_wdt_feed(); // Feed watchdog timer
  }
  Serial.printf("... SBUS initialization succesful!\n");

#elif defined IBUS_COMMUNICATION
  ibusInit = false;
  Serial.printf("Initializing IBUS ...\n");
  Serial.printf("(Make sure radio and receiver are connected, turned on, bound and configured for IBUS output.)\n");
  while (!ibusInit)
  {
    readIbusCommands();               // IBUS communication (pin 36)
    indicatorL.flash(70, 75, 500, 3); // Show 3 fast flashes on indicators!
    indicatorR.flash(70, 75, 500, 3);
    rtc_wdt_feed(); // Feed watchdog timer
  }
  Serial.printf("... IBUS initialization succesful!\n");

#elif defined SUMD_COMMUNICATION
  SUMD_init = false;
  Serial.printf("Initializing SUMD ...\n");
  Serial.printf("(Make sure radio and receiver are connected, turned on, bound and configured for SUMD output.)\n");
  while (!SUMD_init)
  {
    readSumdCommands();
    indicatorL.flash(70, 75, 500, 3); // Show 3 fast flashes on indicators!
    indicatorR.flash(70, 75, 500, 3);
    rtc_wdt_feed(); // Feed watchdog timer
  }
  Serial.printf("... SUMD initialization succesful!\n");

#elif defined PPM_COMMUNICATION
  readPpmCommands();
#else
  // measure PWM RC signals mark space ratio
  readPwmSignals();
  Serial.printf("... PWM communication mode active.\n");
#endif
  Serial.printf("-------------------------------------\n");

  // Calculate RC input signal ranges for all channels
  for (uint8_t i = 1; i < PULSE_ARRAY_SIZE; i++)
  {
    pulseZero[i] = 1500; // Always 1500. This is the center position. Auto centering is now done in "processRawChannels()"

    // Input signals
    pulseMaxNeutral[i] = pulseZero[i] + pulseNeutral;
    pulseMinNeutral[i] = pulseZero[i] - pulseNeutral;
    pulseMax[i] = pulseZero[i] + pulseSpan;
    pulseMin[i] = pulseZero[i] - pulseSpan;
    pulseMaxLimit[i] = pulseZero[i] + pulseLimit;
    pulseMinLimit[i] = pulseZero[i] - pulseLimit;
  }

  // ESC output range calibration
  escPulseMaxNeutral = pulseZero[3] + escTakeoffPunch; // Additional takeoff punch around zero
  escPulseMinNeutral = pulseZero[3] - escTakeoffPunch;

  escPulseMax = pulseZero[3] + escPulseSpan;
  escPulseMin = pulseZero[3] - escPulseSpan + escReversePlus; // Additional power for ESC with slow reverse

  // ESC setup
  setupMcpwmESC(); // ESC now using mpcpwm
#ifdef bp32
  // BluePad32 setup
  Serial.printf("Firmware: %s\n", BP32.firmwareVersion());
  const uint8_t *addr = BP32.localBdAddress();
  Serial.printf("BD Addr: %2X:%2X:%2X:%2X:%2X:%2X\n", addr[0], addr[1], addr[2],
                addr[3], addr[4], addr[5]);

  // Setup the Bluepad32 callbacks
  BP32.setup(&onConnectedGamepad, &onDisconnectedGamepad);

  // "forgetBluetoothKeys()" should be called when the user performs
  // a "device factory reset", or similar.
  // Calling "forgetBluetoothKeys" in setup() just as an example.
  // Forgetting Bluetooth keys prevents "paired" gamepads to reconnect.
  // But might also fix some connection / re-connection issues.
  BP32.forgetBluetoothKeys();
#endif
}

//
// =======================================================================================================
// DAC OFFSET FADER
// =======================================================================================================
//

static unsigned long dacOffsetMicros;
boolean dacInit;

void dacOffsetFade()
{
  if (!dacInit)
  {
    if (micros() - dacOffsetMicros > 100)
    { // Every 0.1ms
      dacOffsetMicros = micros();
      dacOffset++; // fade DAC offset slowly to prevent it from popping, if ESP32 powered up after amplifier
      if (dacOffset == 128)
        dacInit = true;
    }
  }
}

//
// =======================================================================================================
// READ PWM RC SIGNALS (plug in your channels according to order in "channelSetup.h")
// =======================================================================================================
//

void readPwmSignals()
{

  static uint32_t lastFrameTime = millis();

  if (millis() - lastFrameTime > 20)
  { // Only do it every 20ms
    // measure RC signal pulsewidth:
    // nothing is done here, the PWM signals are now read, using the
    // "static void IRAM_ATTR rmt_isr_handler(void* arg)" interrupt function

    // NOTE: There is no channel mapping in this mode! Just plug in the wires in the order as defined in "2_adjustmentsRemote.h"
    // for example: sound controller channel 2 (GEARBOX) connects to receiver channel 6

    // See if we can obtain or "Take" the Semaphore.
    // If the semaphore is not available, wait 1 ticks of the Scheduler to see if it becomes free.
    if (xSemaphoreTake(xPwmSemaphore, portMAX_DELAY))
    {
      // We were able to obtain or "Take" the semaphore and can now access the shared resource.
      // We want to have the pwmBuf variable for us alone,
      // so we don't want it getting stolen during the middle of a conversion.
      for (uint8_t i = 1; i < PWM_CHANNELS_NUM + 1; i++)
      {
        if (pwmBuf[i] > 500 && pwmBuf[i] < 2500)
          pulseWidthRaw[i] = pwmBuf[i]; // Only take valid signals!
      }

      xSemaphoreGive(xPwmSemaphore); // Now free or "Give" the semaphore for others.
    }

    // Normalize, auto zero and reverse channels
    processRawChannels();

    // Failsafe for RC signals
    failSafe = (pulseWidthRaw[3] < 500 || pulseWidthRaw[3] > 2500);
    failsafeRcSignals();

    lastFrameTime = millis();
  }
  else
  {
    xSemaphoreGive(xPwmSemaphore); // Free or "Give" the semaphore for others, if not required!
  }
}

//
// =======================================================================================================
// READ PPM MULTI CHANNEL COMMMANDS (change the channel order in "2_adjustmentsRemote.h", if needed)
// =======================================================================================================
//

void readPpmCommands()
{

  // NOTE: 8 channels is the maximum of this protocol!

  pulseWidthRaw[1] = ppmBuf[STEERING - 1];   // CH1 steering
  pulseWidthRaw[2] = ppmBuf[GEARBOX - 1];    // CH2 3 position switch for gearbox (left throttle in tracked mode)
  pulseWidthRaw[3] = ppmBuf[THROTTLE - 1];   // CH3 throttle & brake
  pulseWidthRaw[4] = ppmBuf[HORN - 1];       // CH5 jake brake, high / low beam, headlight flasher, engine on / off
  pulseWidthRaw[5] = ppmBuf[FUNCTION_R - 1]; // CH5 jake brake, high / low beam, headlight flasher, engine on / off
  pulseWidthRaw[6] = ppmBuf[FUNCTION_L - 1]; // CH6 indicators, hazards
  pulseWidthRaw[7] = ppmBuf[POT2 - 1];       // CH7 pot 2
  pulseWidthRaw[8] = ppmBuf[MODE1 - 1];      // CH8 mode 1 switch

  // Normalize, auto zero and reverse channels
  processRawChannels();

  // Failsafe for RC signals
  failSafe = (pulseWidthRaw[3] < 500 || pulseWidthRaw[3] > 2500);
  failsafeRcSignals();
}

//
// =======================================================================================================
// READ SBUS SIGNALS (change the channel order in "2_adjustmentsRemote.h", if needed)
// =======================================================================================================
//

void readSbusCommands()
{
  // Signals are coming in via SBUS protocol

  static unsigned long lastSbusFailsafe;

  // look for a good SBUS packet from the receiver
#if not defined EMBEDDED_SBUS // ------------------------
  if (sBus.read(&SBUSchannels[0], &SBUSfailSafe, &SBUSlostFrame))
  {
#else  // ------------------------------------------------
  if (sBus.read() && !sBus.failsafe() && !sBus.lost_frame())
  {
#endif // -----------------------------------------------
    sbusInit = true;
    lastSbusFailsafe = millis();
  }

  // Failsafe triggering (works, if SBUS wire is unplugged, but SBUSfailSafe signal from the receiver is untested!)
#if not defined EMBEDDED_SBUS // ------------------------
  if (millis() - lastSbusFailsafe > sbusFailsafeTimeout && !SBUSfailSafe && !SBUSlostFrame)
  {
#else                // ------------------------------------------------
  if (millis() - lastSbusFailsafe > sbusFailsafeTimeout)
  {
#endif               // -----------------------------------------------
    failSafe = true; // if timeout (signal loss)
  }
  else
    failSafe = false;

  // SBUSchannels[NONE - 1] = 991; // The NONE channel needs to be on neutral (991 = 1500ms) TODO

  // Proportional channels (in Microseconds)
  if (!failSafe)
  {
#if defined EMBEDDED_SBUS // ----------------------------
    SBUSchannels = sBus.ch();
#endif                                                                                 // -----------------------------------------------
    pulseWidthRaw[1] = map(SBUSchannels[STEERING - 1], 172, 1811, 1000, 2000);         // CH1 steering
    pulseWidthRaw[2] = map(SBUSchannels[GEARBOX - 1], 172, 1811, 1000, 2000);          // CH2 3 position switch for gearbox (left throttle in tracked mode)
    pulseWidthRaw[3] = map(SBUSchannels[THROTTLE - 1], 172, 1811, 1000, 2000);         // CH3 throttle & brake
    pulseWidthRaw[4] = map(SBUSchannels[HORN - 1], 172, 1811, 1000, 2000);             // CH5 jake brake, high / low beam, headlight flasher, engine on / off
    pulseWidthRaw[5] = map(SBUSchannels[FUNCTION_R - 1], 172, 1811, 1000, 2000);       // CH5 jake brake, high / low beam, headlight flasher, engine on / off
    pulseWidthRaw[6] = map(SBUSchannels[FUNCTION_L - 1], 172, 1811, 1000, 2000);       // CH6 indicators, hazards
    pulseWidthRaw[7] = map(SBUSchannels[POT2 - 1], 172, 1811, 1000, 2000);             // CH7 pot 2
    pulseWidthRaw[8] = map(SBUSchannels[MODE1 - 1], 172, 1811, 1000, 2000);            // CH8 mode 1 switch
    pulseWidthRaw[9] = map(SBUSchannels[MODE2 - 1], 172, 1811, 1000, 2000);            // CH9 mode 2 switch
    pulseWidthRaw[10] = map(SBUSchannels[MOMENTARY1 - 1], 172, 1811, 1000, 2000);      // CH10
    pulseWidthRaw[11] = map(SBUSchannels[HAZARDS - 1], 172, 1811, 1000, 2000);         // CH11
    pulseWidthRaw[12] = map(SBUSchannels[INDICATOR_LEFT - 1], 172, 1811, 1000, 2000);  // CH12
    pulseWidthRaw[13] = map(SBUSchannels[INDICATOR_RIGHT - 1], 172, 1811, 1000, 2000); // CH13
  }

  if (sbusInit)
  {
    // Normalize, auto zero and reverse channels
    processRawChannels();

    // Failsafe for RC signals
    failsafeRcSignals();
  }
}

//
// =======================================================================================================
// READ IBUS SIGNALS (change the channel order in "2_adjustmentsRemote.h", if needed).
// =======================================================================================================
//

// NOTE: "MAX_RPM_PERCENTAGE" > 350 will crash the ESP32, if used in iBus mode!
// Caution, this protocoll does NOT offer failsafe!! Bad contact on iBUS wire = crash!
// Better use SBUS instead, if available!

// IBUS Loop sub function ----
void loopIbus()
{
  // Loop iBus (read signals)
  static unsigned long lastIbusRead;
  static uint16_t iBusReadCycles;
  if (millis() - lastIbusRead > 10)
  { // Every 10ms
    lastIbusRead = millis();
    iBus.loop();
    if (iBusReadCycles < 100)
      iBusReadCycles++;
    else
      ibusInit = true; // We need to process the entire serial package, before we read the channels for the first time! 100 OK? TODO
  }
}

// Read IBUS signals ----
void readIbusCommands()
{

  // Loop iBus (fill buffer)
  loopIbus();

  // NOTE: The channel mapping is in the order as defined in "channelsetup.h"
  // for example: sound controller channel 2 (GEARBOX) connects to receiver channel 6

  // Proportional channels (in Microseconds)
  pulseWidthRaw[1] = iBus.readChannel(STEERING - 1);         // CH1 steering
  pulseWidthRaw[2] = iBus.readChannel(GEARBOX - 1);          // CH2 3 position switch for gearbox (left throttle in tracked mode)
  pulseWidthRaw[3] = iBus.readChannel(THROTTLE - 1);         // CH3 throttle & brake
  pulseWidthRaw[4] = iBus.readChannel(HORN - 1);             // CH5 jake brake, high / low beam, headlight flasher, engine on / off
  pulseWidthRaw[5] = iBus.readChannel(FUNCTION_R - 1);       // CH5 jake brake, high / low beam, headlight flasher, engine on / off
  pulseWidthRaw[6] = iBus.readChannel(FUNCTION_L - 1);       // CH6 indicators, hazards
  pulseWidthRaw[7] = iBus.readChannel(POT2 - 1);             // CH7 pot 2
  pulseWidthRaw[8] = iBus.readChannel(MODE1 - 1);            // CH8 mode 1 switch
  pulseWidthRaw[9] = iBus.readChannel(MODE2 - 1);            // CH9 mode 2 switch
  pulseWidthRaw[10] = iBus.readChannel(MOMENTARY1 - 1);      // CH10
  pulseWidthRaw[11] = iBus.readChannel(HAZARDS - 1);         // CH11
  pulseWidthRaw[12] = iBus.readChannel(INDICATOR_LEFT - 1);  // CH12
  pulseWidthRaw[13] = iBus.readChannel(INDICATOR_RIGHT - 1); // CH13

  if (ibusInit)
  {
    // Normalize, auto zero and reverse channels
    processRawChannels();
  }
}

//
// =======================================================================================================
// READ SUMD SIGNALS (change the channel order in "2_adjustmentsRemote.h", if needed).
// =======================================================================================================
//
void readSumdCommands()
{
#if defined SUMD_COMMUNICATION
  // Signals are coming in via Graupner SUMD protocol

  // look for a good SUMD packet from the receiver
  if (sumd.read(SUMDchannels, &SUMD_failsafe, &SUMD_frame_lost) == 0)
  {
    SUMD_init = true;
  }

  // Proportional channels (in Microseconds)
  pulseWidthRaw[1] = map(SUMDchannels[STEERING - 1], 1100, 1900, 1000, 2000);    // CH1 steering
  pulseWidthRaw[2] = map(SUMDchannels[GEARBOX - 1], 1100, 1900, 1000, 2000);     // CH2 3 position switch for gearbox (left throttle in tracked mode)
  pulseWidthRaw[3] = map(SUMDchannels[THROTTLE - 1], 1100, 1900, 1000, 2000);    // CH3 throttle & brake
  pulseWidthRaw[4] = map(SUMDchannels[HORN - 1], 1100, 1900, 1000, 2000);        // CH5 jake brake, high / low beam, headlight flasher, engine on / off
  pulseWidthRaw[5] = map(SUMDchannels[FUNCTION_R - 1], 1100, 1900, 1000, 2000);  // CH5 jake brake, high / low beam, headlight flasher, engine on / off
  pulseWidthRaw[6] = map(SUMDchannels[FUNCTION_L - 1], 1100, 1900, 1000, 2000);  // CH6 indicators, hazards
  pulseWidthRaw[7] = map(SUMDchannels[POT2 - 1], 1100, 1900, 1000, 2000);        // CH7 pot 2
  pulseWidthRaw[8] = map(SUMDchannels[MODE1 - 1], 1100, 1900, 1000, 2000);       // CH8 mode 1 switch
  pulseWidthRaw[9] = map(SUMDchannels[MODE2 - 1], 1100, 1900, 1000, 2000);       // CH9 mode 2 switch
  pulseWidthRaw[10] = map(SUMDchannels[MOMENTARY1 - 1], 1100, 1900, 1000, 2000); // CH10
  pulseWidthRaw[11] = map(SUMDchannels[HAZARDS - 1], 1100, 1900, 1000, 2000);    // CH11

  // Failsafe triggering
  if (SUMD_failsafe)
  {
    failSafe = true; // in most cases the rx buffer is not processed fast enough so old data is overwritten
  }
  else
    failSafe = false;

  if (SUMD_init)
  { // TODO, experimental!
    // Normalize, auto zero and reverse channels
    processRawChannels();

    // Failsafe for RC signals
    failsafeRcSignals();
  }
#endif
}

//
// =======================================================================================================
// PROCESS CHANNELS (Normalize, auto zero and reverse)
// =======================================================================================================
//

void processRawChannels()
{

  static unsigned long lastOutOfRangeMillis;
  static int channel;
  static bool exThrottlePrint;
  static bool exSteeringPrint;

#ifdef TRACKED_MODE // If tracked mode: enable CH2 auto zero adjustment as well, if it is enabled for CH3
  if (channelAutoZero[3])
    channelAutoZero[2] = true;
#endif

#ifdef AIRPLANE_MODE // If airplane mode: always disable CH3 auto zero adjustment
  channelAutoZero[3] = false;
#endif

  if (millis() - lastOutOfRangeMillis > 500)
  {
    for (uint8_t i = 1; i < PULSE_ARRAY_SIZE; i++)
    { // For each channel:

      // Position valid for auto calibration? Must be between 1400 and 1600 microseconds
      if (channelAutoZero[i] && !autoZeroDone && (pulseWidthRaw[i] > 1600 || pulseWidthRaw[i] < 1400))
      {
        channel = i;
        Serial.printf(" CH%i: signal out of auto calibration range, check transmitter & receiver!\n", channel);
        channelZero();
        lastOutOfRangeMillis = millis();
        i--;
        return;
      }

      // Exponential throttle compensation ------------------
#ifdef EXPONENTIAL_THROTTLE
      if (!exThrottlePrint)
      {
        Serial.printf("EXPONENTIAL_THROTTLE mode enabled\n");
        exThrottlePrint = true;
      }
      if (i == 3)
      { // Throttle CH only
        pulseWidthRaw2[i] = reMap(curveExponentialThrottle, pulseWidthRaw[i]);
      }
      else
      {
        pulseWidthRaw2[i] = pulseWidthRaw[i];
      }
#else
      pulseWidthRaw2[i] = pulseWidthRaw[i];
#endif // --------------------------------------------------

      // Exponential steering compensation ------------------
#ifdef EXPONENTIAL_STEERING
      if (!exSteeringPrint)
      {
        Serial.printf("EXPONENTIAL_STEERING mode enabled\n");
        exSteeringPrint = true;
      }
      if (i == 1)
      { // Throttle CH only
        pulseWidthRaw2[i] = reMap(curveExponentialThrottle, pulseWidthRaw[i]);
      }
      else
      {
        pulseWidthRaw2[i] = pulseWidthRaw[i];
      }
#else
      pulseWidthRaw2[i] = pulseWidthRaw[i];
#endif // --------------------------------------------------

      // Take channel raw data, reverse them, if required and store them
      if (channelReversed[i])
        pulseWidthRaw3[i] = map(pulseWidthRaw2[i], 0, 3000, 3000, 0); // Reversed
      else
        pulseWidthRaw3[i] = pulseWidthRaw2[i]; // Not reversed

      // Calculate zero offset (only within certain absolute range)
      if (channelAutoZero[i] && !autoZeroDone && pulseWidthRaw3[i] > pulseMinValid && pulseWidthRaw3[i] < pulseMaxValid)
        pulseOffset[i] = 1500 - pulseWidthRaw3[i];

      // Center channel, if out of range!
      if (pulseWidthRaw3[i] > pulseMaxValid || pulseWidthRaw3[i] < pulseMinValid)
        pulseWidthRaw3[i] = pulseZero[i];

      // Limit channel, if out of range (required for RGT  MT-350 @ max. throttle dual rate)
      if (pulseWidthRaw3[i] > 2000)
        pulseWidthRaw3[i] = 2000;
      if (pulseWidthRaw3[i] < 1000)
        pulseWidthRaw3[i] = 1000;

      // Compensate pulsewidth with auto zero offset
      pulseWidthRaw3[i] += pulseOffset[i];
      if (!autoZeroDone)
      { // Print offsets, if switching on the controller
        if (i == 1)
          Serial.printf("\nTransmitter channel offsets (calculated, if channelAutoZero[] = true):\n");
        if (channelAutoZero[i])
          Serial.printf(" CH%i: %i µs\n", i, pulseOffset[i]);
      }

      // Set auto zero done flag
      if (i == PULSE_ARRAY_SIZE - 1)
        autoZeroDone = true;
    }
  }

  if (!autoZeroDone)
  {                                           // Indicators are showing the number of channels, which are out of auto calibration range
    indicatorL.flash(140, 150, 500, channel); // ON, OFF, PAUSE, PULSES, (OPTIONAL DELAY FOR FIRST PASS)
    indicatorR.flash(140, 150, 500, channel);
  }

#if defined CHANNEL_AVERAGING // --------------------------------------------------------------------------------
  uint16_t n = 4;             // 2 - 4 !
  static bool initDone = false;
  static uint32_t smoothed[PULSE_ARRAY_SIZE];
  static unsigned long averagingMillis = millis();

  if (millis() - averagingMillis > 15)
  { // Every 15ms (SBUS packets are coming in every 14ms)
    averagingMillis = millis();
    for (uint8_t i = 1; i < PULSE_ARRAY_SIZE; i++)
    { // With averaging -----
      if (initDone)
      {
        smoothed[i] = (smoothed[i] * (n - 1) + pulseWidthRaw3[i]) / n;
        pulseWidth[i] = smoothed[i];
      }
      else
      {
        smoothed[i] = pulseWidthRaw3[i];
        pulseWidth[i] = pulseWidthRaw3[i];
        if (i >= PULSE_ARRAY_SIZE - 1)
          initDone = true;
      }
    }
  }
#else // Without averaging -----
  for (uint8_t i = 1; i < PULSE_ARRAY_SIZE; i++)
  {
    pulseWidth[i] = pulseWidthRaw3[i];
  }
#endif

  // Print input signal debug infos -----------------------------------------------------------------------------
#ifdef CHANNEL_DEBUG // can slow down the playback loop!
  static unsigned long printChannelMillis;
  if (millis() - printChannelMillis > 1000 && autoZeroDone)
  { // Every 1000ms
    printChannelMillis = millis();

    Serial.printf("CHANNEL_DEBUG:\n");
    for (uint8_t channelNum = 1; channelNum < PULSE_ARRAY_SIZE; channelNum++)
    {
      Serial.printf(" CH%i: %i µs\n", channelNum, pulseWidth[channelNum]);
    }
    Serial.printf("Throttle: %i/%i\n", currentThrottle, maxRpm);
    Serial.printf("States:\n");
    Serial.printf(" MODE1:            %s\n", mode1 ? "true" : "false");
    Serial.printf(" MODE2:            %s\n", mode2 ? "true" : "false");
    Serial.printf(" MOMENTARY1:       %s\n", momentary1 ? "true" : "false");
    Serial.printf(" HAZARDS:          %s\n", hazard ? "true" : "false");
    Serial.printf(" INDICATOR_LEFT:   %s\n", indicatorLon ? "true" : "false");
    Serial.printf(" INDICATOR_RIGHT:  %s\n", indicatorRon ? "true" : "false");
#if not defined EMBEDDED_SBUS // ------------------------
    Serial.printf(" SBUS Failsafe:    %s\n", SBUSfailSafe ? "true" : "false");
    Serial.printf(" SBUS Lost frames: %s\n", SBUSlostFrame ? "true" : "false");
#endif // -----------------------------------------------
    Serial.printf(" Failsafe state:   %s\n", failSafe ? "true" : "false");
    Serial.printf("Misc:\n");
    Serial.printf(" MAX_RPM_PERCENTAGE: %i\n", MAX_RPM_PERCENTAGE);
    Serial.printf(" loopTime:           %i\n", loopTime);
    Serial.printf("-----------------------------------\n");
  }
#endif // CHANNEL_DEBUG
}

// Sub function for channel centering ----
void channelZero()
{
  for (uint8_t i = 1; i < PULSE_ARRAY_SIZE; i++)
  {
    pulseWidth[i] = 1500;
  }
}

//
// =======================================================================================================
// RC SIGNAL FAILSAFE POSITIONS (if serial signal lost)
// =======================================================================================================
//

void failsafeRcSignals()
{

  // Failsafe actions --------
  if (failSafe)
  {
    for (uint8_t i = 1; i < PULSE_ARRAY_SIZE; i++)
    {
      if (i != 1 && i != 2 && i != 8 && i != 9)
        pulseWidth[i] = pulseZero[i]; // Channels to zero position, but never for CH1 (Steering), CH8, CH9
    }
  }
}

//
// =======================================================================================================
// ROTATING BEACON CONTROL (BUS communication mode only)
// =======================================================================================================
//

bool beaconControl(uint8_t pulses)
{

  /* Beacons: "RC DIY LED Rotating Beacon Light Flash For 1/10 Truck Crawler Toy"
      from: https://www.ebay.ch/itm/303979210629
      States (every servo signal change from 1000 to 2000us will switch to the next state):
      0 rotating beacon slow
      1 Rotating beacon slow
      2 4x flash
      3 endless flash
      4 off

  */

  static unsigned long pulseMillis;
  static unsigned long pulseWidth = CH3L;
  static uint8_t i;

  if (millis() - pulseMillis > 40)
  { // Every 40ms (this is the required minimum)
    pulseMillis = millis();
    if (pulseWidth == CH3L)
    {
      pulseWidth = CH3R;
    }
    else
    {
      pulseWidth = CH3L;
      i++;
    }
    mcpwm_set_duty_in_us(MCPWM_UNIT_0, MCPWM_TIMER_1, MCPWM_OPR_B, pulseWidth);
  }

  if (i >= pulses)
  {
    i = 0;
    return true;
  }
  else
    return false;
}

//
// =======================================================================================================
// MCPWM SERVO RC SIGNAL OUTPUT (BUS communication mode only)
// =======================================================================================================
//
// See: https://docs.espressif.com/projects/esp-idf/en/latest/esp32/api-reference/peripherals/mcpwm.html#configure

void mcpwmOutput()
{
  if (autoZeroDone) // Only generate servo signals, if auto zero was successful!
  {

    // Steering CH1 **********************
    uint16_t steeringServoMicros;
    static uint16_t steeringServoMicrosDelayed = CH1C;
    static unsigned long steeringDelayMicros;
    int16_t steeringDeviation = 1;
    if (micros() - steeringDelayMicros > STEERING_RAMP_TIME)
    { // Adjustable steering max. ramp speed
      // It is required to calculate a variable deviation, according to how much "delay" the steering ramp time has
      // Reason: we have a high interrupt load at high engine RPM. The servo movements are getting too slow otherwise
      steeringDeviation = (micros() - steeringDelayMicros) - STEERING_RAMP_TIME;
      steeringDeviation = constrain(steeringDeviation, 1, 10);
      steeringDelayMicros = micros();

      if (pulseWidth[1] < 1500)
        steeringServoMicros = map(pulseWidth[1], 1000, 1500, CH1L, CH1C);
      else if (pulseWidth[1] > 1500)
        steeringServoMicros = map(pulseWidth[1], 1500, 2000, CH1C, CH1R);
      else
        steeringServoMicros = CH1C;
      if (steeringServoMicrosDelayed < steeringServoMicros)
        steeringServoMicrosDelayed += steeringDeviation;
      if (steeringServoMicrosDelayed > steeringServoMicros)
        steeringServoMicrosDelayed -= steeringDeviation;
      steeringServoMicrosDelayed = constrain(steeringServoMicrosDelayed, min(CH1L, CH1R), max(CH1L, CH1R));
      // Serial.printf("steeringServoMicros: %s\n", steeringServoMicros);
      // Serial.printf("steeringServoMicrosDelayed: %s\n", steeringServoMicrosDelayed);
      mcpwm_set_duty_in_us(MCPWM_UNIT_0, MCPWM_TIMER_0, MCPWM_OPR_A, steeringServoMicrosDelayed);
    }

    // Shifting CH2 **********************
    static uint16_t shiftingServoMicros;
#if not defined MODE1_SHIFTING
    if (selectedGear == 1)
      shiftingServoMicros = CH2L;
    if (selectedGear == 2)
      shiftingServoMicros = CH2C;
    if (selectedGear >= 3)
      shiftingServoMicros = CH2R;
#else
#undef TRANSMISSION_NEUTRAL // Not usable in this case!
    if (currentSpeed > 50 && currentSpeed < 150)
    { // Only shift WPL gearbox, if vehicle is moving slowly, so it's engaging properly
      if (!mode1)
      {
        shiftingServoMicros = CH2L;
        lowRange = true;
      }
      else
      {
        shiftingServoMicros = CH2C;
        lowRange = false;
      }
    }
#endif
    mcpwm_set_duty_in_us(MCPWM_UNIT_0, MCPWM_TIMER_0, MCPWM_OPR_B, shiftingServoMicros);

    // Winch CH3 **********************
#if defined NO_WINCH_DELAY
    uint16_t winchDelayTarget = 0; // Servo signal for winch is changed immediately
#else
    uint16_t winchDelayTarget = 12000; // Servo signal for winch is changed slowly
#endif

#if defined MODE2_WINCH
    static uint16_t winchServoMicrosTarget = CH3C;
    static uint16_t winchServoMicros = CH3C;
    static unsigned long winchDelayMicros;
    if (micros() - winchDelayMicros > winchDelayTarget)
    {
      winchDelayMicros = micros();
      if (winchPull)
        winchServoMicrosTarget = CH3L;
      else if (winchRelease)
        winchServoMicrosTarget = CH3R;
      else
        winchServoMicrosTarget = CH3C;
      if (winchServoMicros < winchServoMicrosTarget)
        winchServoMicros++;
      if (winchServoMicros > winchServoMicrosTarget)
        winchServoMicros--;
    }
    mcpwm_set_duty_in_us(MCPWM_UNIT_0, MCPWM_TIMER_1, MCPWM_OPR_B, winchServoMicros);
#endif

    // Beacon CH3 **********************
#if defined CH3_BEACON

    // Init (5 pulses are required to shut beacons off after power on)
    static bool blueLightInit;
    if (!blueLightInit)
    {
      if (beaconControl(5))
        blueLightInit = true;
    }

    // Switching modes
    static uint16_t beaconServoMicros;
    static bool lockRotating, lockOff;
    if (blueLightInit)
    {
      if (blueLightTrigger && !lockRotating)
      { // Rotating mode on (1 pulse)
        if (beaconControl(1))
        {
          lockRotating = true;
          lockOff = false;
        }
      }
      if (!blueLightTrigger && !lockOff && lockRotating)
      { // Off (4 pulses)
        if (beaconControl(4))
        {
          lockOff = true;
          lockRotating = false;
        }
      }
    }
#endif

    // Trailer coupler (5th wheel) CH4 **********************
    static uint16_t couplerServoMicros;
    if (unlock5thWheel)
      couplerServoMicros = CH4R;
    else
      couplerServoMicros = CH4L;
    mcpwm_set_duty_in_us(MCPWM_UNIT_0, MCPWM_TIMER_1, MCPWM_OPR_A, couplerServoMicros);
  }

  // Print servo signal debug infos **********************
  static unsigned long printServoMillis;
#ifdef SERVO_DEBUG // can slow down the playback loop!
  if (millis() - printServoMillis > 1000)
  { // Every 1000ms
    printServoMillis = millis();

    Serial.printf("SERVO_DEBUG:\n");
    Serial.printf("CH1 (steering) :  %i µS, %.2f°\n", steeringServoMicrosDelayed, us2degree(steeringServoMicrosDelayed));
    Serial.printf("CH2 (shifting) :  %i µS, %.2f°\n", shiftingServoMicros, us2degree(shiftingServoMicros));

#if defined MODE2_WINCH
    Serial.printf("CH3 (winch)    :  %i µS, %f°\n", winchServoMicros, us2degree(winchServoMicros));
#endif

#if defined CH3_BEACON
    Serial.printf("CH3 (beacon)    :  %i µS, %f°\n", beaconServoMicros, us2degree(beaconServoMicros));
#endif

    Serial.printf("CH4 (5th wheel):  %i µS, %.2f°\n", couplerServoMicros, us2degree(couplerServoMicros));
    Serial.printf("-------------------------------------\n");
  }
#endif // SERVO_DEBUG
}

//
// =======================================================================================================
// DISABLE INTERRUPTS
// =======================================================================================================
//

// it is required to disable interrupts prior to EEPROM access!
void disableAllInterrupts()
{

  timerDetachInterrupt(variableTimer);
  timerDetachInterrupt(fixedTimer);

  Serial.print("Interrupts disabled, reboot required!");
}

//
// =======================================================================================================
// EEPROM
// =======================================================================================================
//

// Write string to EEPROM ------
// https://roboticsbackend.com/arduino-write-string-in-eeprom/#Write_the_String

int writeStringToEEPROM(int addrOffset, const String &strToWrite)
{
  byte len = strToWrite.length();
  EEPROM.write(addrOffset, len);
  for (int i = 0; i < len; i++)
  {
    EEPROM.write(addrOffset + 1 + i, strToWrite[i]);
  }
  return addrOffset + 1 + len;
}

// Read string from EEPROM ------
int readStringFromEEPROM(int addrOffset, String *strToRead)
{
  int newStrLen = EEPROM.read(addrOffset);
  char data[newStrLen + 1];
  for (int i = 0; i < newStrLen; i++)
  {
    data[i] = EEPROM.read(addrOffset + 1 + i);
  }
  data[newStrLen] = '\0';
  *strToRead = String(data);
  return addrOffset + 1 + newStrLen;
}

// Erase EEPROM ------
void eepromErase()
{
  for (int i = 0; i < EEPROM_SIZE; i++)
  {
    EEPROM.write(i, 0);
  }
  EEPROM.commit();
  Serial.println("EEPROM erased!");
  delay(500);
  eepromDebugRead();
}
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
void loop()
{

#if defined SBUS_COMMUNICATION
  readSbusCommands(); // SBUS communication (pin 36)
  mcpwmOutput();      // PWM servo signal output

#elif defined IBUS_COMMUNICATION
  readIbusCommands(); // IBUS communication (pin 36)
  mcpwmOutput();      // PWM servo signal output

#elif defined SUMD_COMMUNICATION
  readSumdCommands(); // SUMD communication (pin 36)
  mcpwmOutput();      // PWM servo signal output

#elif defined PPM_COMMUNICATION
  readPpmCommands(); // PPM communication (pin 36)
  mcpwmOutput();     // PWM servo signal output

#else
  // measure RC signals mark space ratio
  readPwmSignals();
#endif

  // Horn triggering
  triggerHorn();

  // Indicator (turn signal) triggering
  triggerIndicators();

  if (xSemaphoreTake(xRpmSemaphore, portMAX_DELAY))
  {
    // Map pulsewidth to throttle
    mapThrottle();

    // rcTrigger
    rcTriggerRead();

    // Excavator specific controls
#if defined EXCAVATOR_MODE
    excavatorControl();
#endif

    // Steam locomotive specific controls
#if defined STEAM_LOCOMOTIVE_MODE
    steamLocomotiveControl();
#endif

    // Dashboard control
#if defined SPI_DASHBOARD
    updateDashboard();
#endif
    xSemaphoreGive(xRpmSemaphore); // Now free or "Give" the semaphore for others.
  }

  // Read trailer switch state
#if not defined THIRD_BRAKELIGHT and not defined RZ7886_DRIVER_MODE
  trailerPresenceSwitchRead();
#endif

  // RGB LED control
#if defined NEOPIXEL_ENABLED
  updateRGBLEDs();
#endif

  // Trailer control, using ESP NOW
  trailerControl();

  // Core ID debug
#if defined CORE_DEBUG
  Serial.print("Running on core ");
  Serial.println(coreId);
#endif
#ifdef bp32
  static unsigned long refTime = 0;
  if(millis() - refTime > 150){
    BP32.update();

    // It is safe to always do this before using the gamepad API.
    // This guarantees that the gamepad is valid and connected.
    for (int i = 0; i < BP32_MAX_GAMEPADS; i++) {
      GamepadPtr myGamepad = myGamepads[i];

      if (myGamepad && myGamepad->isConnected()) {
        // There are different ways to query whether a button is pressed.
        // By query each button individually:
        //  a(), b(), x(), y(), l1(), etc...
        if (myGamepad->a()) {
          static int colorIdx = 0;
          // Some gamepads like DS4 and DualSense support changing the color LED.
          // It is possible to change it by calling:
          switch (colorIdx % 3) {
          case 0:
            // Red
            myGamepad->setColorLED(255, 0, 0);
            break;
          case 1:
            // Green
            myGamepad->setColorLED(0, 255, 0);
            break;
          case 2:
            // Blue
            myGamepad->setColorLED(0, 0, 255);
            break;
          }
          colorIdx++;
        }

        if (myGamepad->b()) {
          // Turn on the 4 LED. Each bit represents one LED.
          static int led = 0;
          led++;
          // Some gamepads like the DS3, DualSense, Nintendo Wii, Nintendo Switch
          // support changing the "Player LEDs": those 4 LEDs that usually
          // indicate the "gamepad seat". It is possible to change them by
          // calling:
          myGamepad->setPlayerLEDs(led & 0x0f);
        }

        if (myGamepad->x()) {
          // Duration: 255 is ~2 seconds
          // force: intensity
          // Some gamepads like DS3, DS4, DualSense, Switch, Xbox One S support
          // rumble.
          // It is possible to set it by calling:
          myGamepad->setRumble(0xc0 /* force */, 0xc0 /* duration */);
        }

        // Another way to query the buttons, is by calling buttons(), or
        // miscButtons() which return a bitmask.
        // Some gamepads also have DPAD, axis and more.
        Serial.printf(
            "idx=%d, dpad: 0x%02x, buttons: 0x%04x, axis L: %4d, %4d, axis R: "
            "%4d, %4d, brake: %4d, throttle: %4d, misc: 0x%02x, gyro x:%6d y:%6d "
            "z:%6d, accel x:%6d y:%6d z:%6d\n",
            i,                        // Gamepad Index
            myGamepad->dpad(),        // DPAD
            myGamepad->buttons(),     // bitmask of pressed buttons
            myGamepad->axisX(),       // (-511 - 512) left X Axis
            myGamepad->axisY(),       // (-511 - 512) left Y axis
            myGamepad->axisRX(),      // (-511 - 512) right X axis
            myGamepad->axisRY(),      // (-511 - 512) right Y axis
            myGamepad->brake(),       // (0 - 1023): brake button
            myGamepad->throttle(),    // (0 - 1023): throttle (AKA gas) button
            myGamepad->miscButtons(), // bitmak of pressed "misc" buttons
            myGamepad->gyroX(),       // Gyro X
            myGamepad->gyroY(),       // Gyro Y
            myGamepad->gyroZ(),       // Gyro Z
            myGamepad->accelX(),      // Accelerometer X
            myGamepad->accelY(),      // Accelerometer Y
            myGamepad->accelZ()       // Accelerometer Z
        );

        // You can query the axis and other properties as well. See Gamepad.h
        // For all the available functions.
      }
    }
  }
#endif
  // Feeding the RTC watchtog timer is essential!
  rtc_wdt_feed();
}

//
// =======================================================================================================
// 1st MAIN TASK, RUNNING ON CORE 0 (Interrupts are running on this core as well)
// =======================================================================================================
//

void Task1code(void *pvParameters)
{
  for (;;)
  {

    // coreId = xPortGetCoreID(); // Running on core 0

    // DAC offset fader
    dacOffsetFade();

    if (xSemaphoreTake(xRpmSemaphore, portMAX_DELAY))
    {
      // Simulate engine mass, generate RPM signal
      engineMassSimulation();

      // Call gear selector
      if (automatic || doubleClutch)
        automaticGearSelector();
      xSemaphoreGive(xRpmSemaphore); // Now free or "Give" the semaphore for others.
    }

    // Switch engine on or off
    engineOnOff();

    // LED control
    if (autoZeroDone)
      led();

#if not defined SPI_DASHBOARD
    // Shaker control
    shaker();
#endif

    // Gearbox detection
    gearboxDetection();

    // ESC control & low discharge protection
    esc();

    // measure loop time
    loopTime = loopDuration(); // for debug only

    // Feeding the RTC watchtog timer is essential!
    rtc_wdt_feed(); // TODO, test only
  }
}
