aspyra/Rc_Engine_Sound_ESP32/(commit log)

2023-11-29 Added hardware variant with built-in ESC
    [RC_Engine_Sound_ESP32.kicad_pcb, RC_Engine_Sound_ESP32.kicad_sch]
2023-11-29 Updated some options to match WPL B16 (PWM receiver)
2023-12-01 Downgraded ESP-IDF version to 3.0.0 in platformio.ini to match ESP32 board def v1.0.4 in Arduino IDE. Temporarily removed ESP32AnalogRead use because it doesn't work with 3.0.0 / v1.0.4.
    [src.ino]
